redmanduck/wins/README.md

# Wi-Fi Indoor Navigation System 

GPS is the standard for navigation in embedded electronics today, but GPS signals are largely incapable of penetrating structures and providing an accurate or functional navigation system for indoor use. The Indoor Navigation System project is an attempt to address this issue, by combining multiple sensor techniques together to provide an accurate means of navigating an object indoors.

[Map]

Package (https://dl.dropboxusercontent.com/u/41564792/pi.png)
