redmanduck/wins/pic/last_working.X/Makefile.htm

Skip to content

(https://github.com/)

This repository

- Explore
- Gist (https://gist.github.com)
- Blog
- Help (https://help.github.com)
- @dkenzheb dkenzheb
  - New repository
  - New organization
  - This repository
  - New issue
- Unwatch 4
  Notifications
  Not watching Be notified when participating or @mentioned. Watch
  Watching Be notified of all conversations. Unwatch
  Ignoring Never be notified. Stop ignoring
- Unstar 1
  Star 1
- Fork 0

# ssabpisa/wins private 

### HTTPS clone URL

### SSH clone URL

### Subversion checkout URL

You can clone with HTTPS, SSH, or Subversion. (https://help.github.com/articles/which-remote-url-should-i-use)

Clone in Desktop (https://windows.github.com) Download ZIP

Permalink

branch: master

Switch branches/tags

- Branches
- Tags

master

Create branch: from ‘master’

Nothing to show

wins/pic/project.X/Makefile

Fetching contributors…



Cannot retrieve contributors at this time

Raw Blame History

(https://windows.github.com)

114 lines (87 sloc) 3.381 kb

| # There exist several targets which are by default empty and which can be
| # used for execution of your targets. These targets are usually executed
| # before and after some main targets. They are:
| # .build-pre: called before 'build' target
| # .build-post: called after 'build' target
| # .clean-pre: called before 'clean' target
| # .clean-post: called after 'clean' target
| # .clobber-pre: called before 'clobber' target
| # .clobber-post: called after 'clobber' target
| # .all-pre: called before 'all' target
| # .all-post: called after 'all' target
| # .help-pre: called before 'help' target
| # .help-post: called after 'help' target
| # Targets beginning with '.' are not intended to be called on their own.
| # Main targets can be executed directly, and they are:
| # build build a specific configuration
| # clean remove built files from a configuration
| # clobber remove all built files
| # all build all configurations
| # help print help mesage
| # Targets .build-impl, .clean-impl, .clobber-impl, .all-impl, and
| # .help-impl are implemented in nbproject/makefile-impl.mk.
| # Available make variables:
| # CND_BASEDIR base directory for relative paths
| # CND_DISTDIR default top distribution directory (build artifacts)
| # CND_BUILDDIR default top build directory (object files, ...)
| # CONF name of current configuration
| # CND_ARTIFACT_DIR_${CONF} directory of build artifact (current configuration)
| # CND_ARTIFACT_NAME_${CONF} name of build artifact (current configuration)
| # CND_ARTIFACT_PATH_${CONF} path to build artifact (current configuration)
| # CND_PACKAGE_DIR_${CONF} directory of package (current configuration)
| # CND_PACKAGE_NAME_${CONF} name of package (current configuration)
| # CND_PACKAGE_PATH_${CONF} path to package (current configuration)
| # NOCDDL
| # Environment
| MKDIR=mkdir
| CP=cp
| CCADMIN=CCadmin
| RANLIB=ranlib
| # build
| build: .build-post
| .build-pre:
| # Add your pre 'build' code here...
| .build-post: .build-impl
| # Add your post 'build' code here...
| # clean
| clean: .clean-post
| .clean-pre:
| # Add your pre 'clean' code here...
| # WARNING: the IDE does not call this target since it takes a long time to
| # simply run make. Instead, the IDE removes the configuration directories
| # under build and dist directly without calling make.
| # This target is left here so people can do a clean when running a clean
| # outside the IDE.
| .clean-post: .clean-impl
| # Add your post 'clean' code here...
| # clobber
| clobber: .clobber-post
| .clobber-pre:
| # Add your pre 'clobber' code here...
| .clobber-post: .clobber-impl
| # Add your post 'clobber' code here...
| # all
| all: .all-post
| .all-pre:
| # Add your pre 'all' code here...
| .all-post: .all-impl
| # Add your post 'all' code here...
| # help
| help: .help-post
| .help-pre:
| # Add your pre 'help' code here...
| .help-post: .help-impl
| # Add your post 'help' code here...
| # include project implementation makefile
| include nbproject/Makefile-impl.mk
| # include project make variables
| include nbproject/Makefile-variables.mk

Go

- Status (https://status.github.com/)
- API (https://developer.github.com)
- Training (https://training.github.com)
- Shop (https://shop.github.com)
- Blog (https://github.com/blog)
- About (https://github.com/about)

(https://github.com)

- © 2015 GitHub, Inc.
- Terms (https://github.com/site/terms)
- Privacy (https://github.com/site/privacy)
- Security (https://github.com/security)
- Contact (https://github.com/contact)

Something went wrong with that request. Please try again.
