redmanduck/wins/raspi/localization/results/plots/0_f0_25_72_70_9e_7f.png

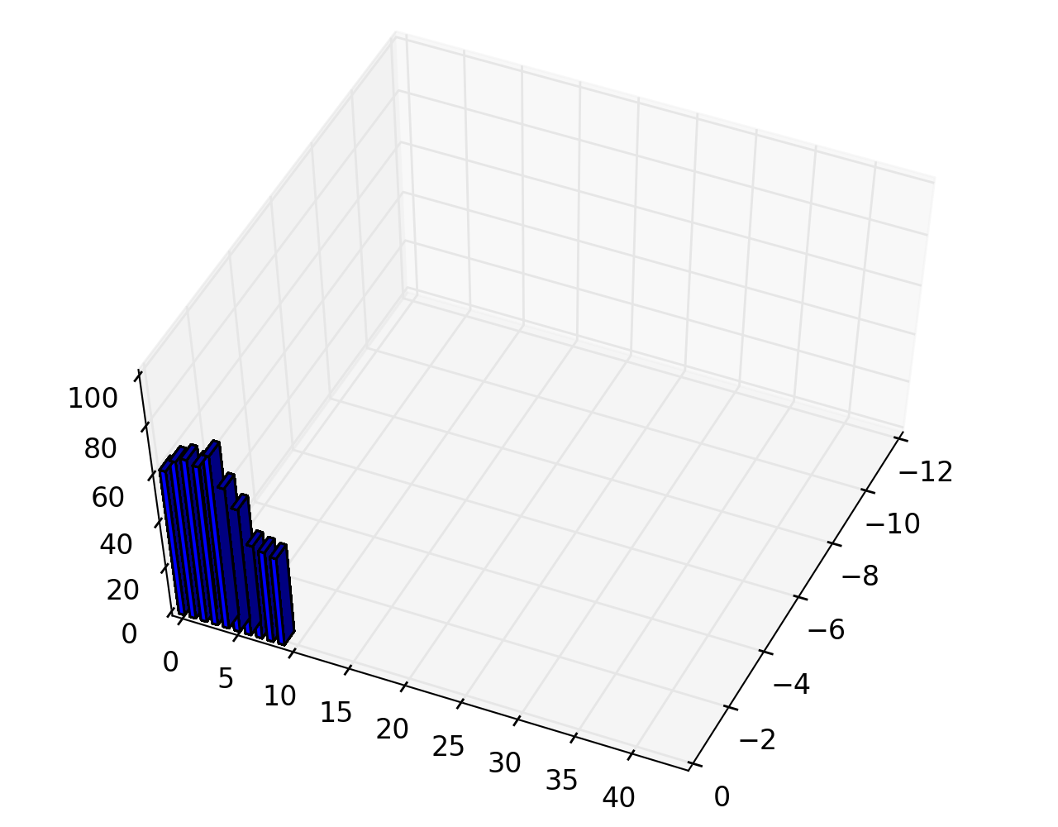
raspi/localization/results/plots/0_f0_25_72_70_9e_7f.png
