redmanduck/wins/raspi/localization/results/plots/1_f0_25_72_7d_8b_3d.png

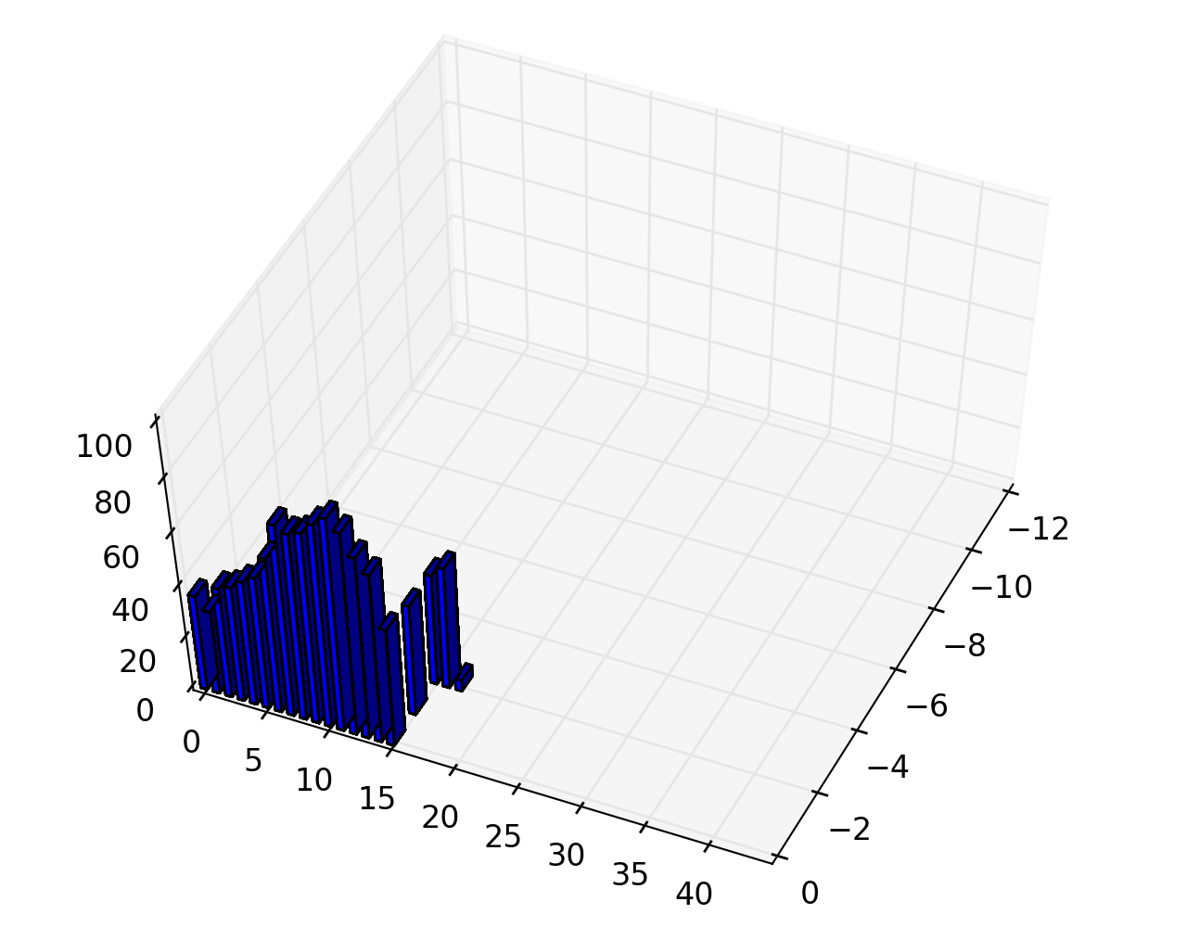
raspi/localization/results/plots/1_f0_25_72_7d_8b_3d.png
