redmanduck/wins/raspi/localization/results/plots/70_00_22_75_43_1f_68.png

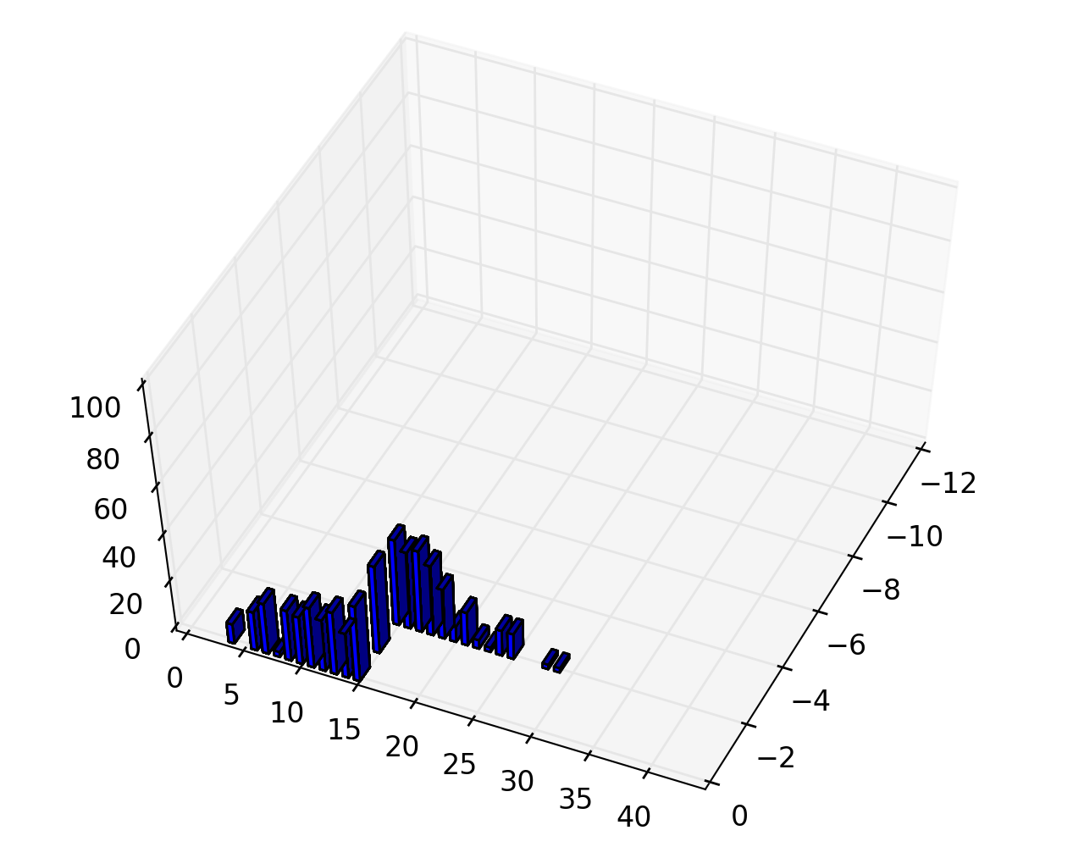
raspi/localization/results/plots/70_00_22_75_43_1f_68.png
