redmanduck/wins/raspi/localization/results/plots/105_f0_25_72_7d_88_79.png

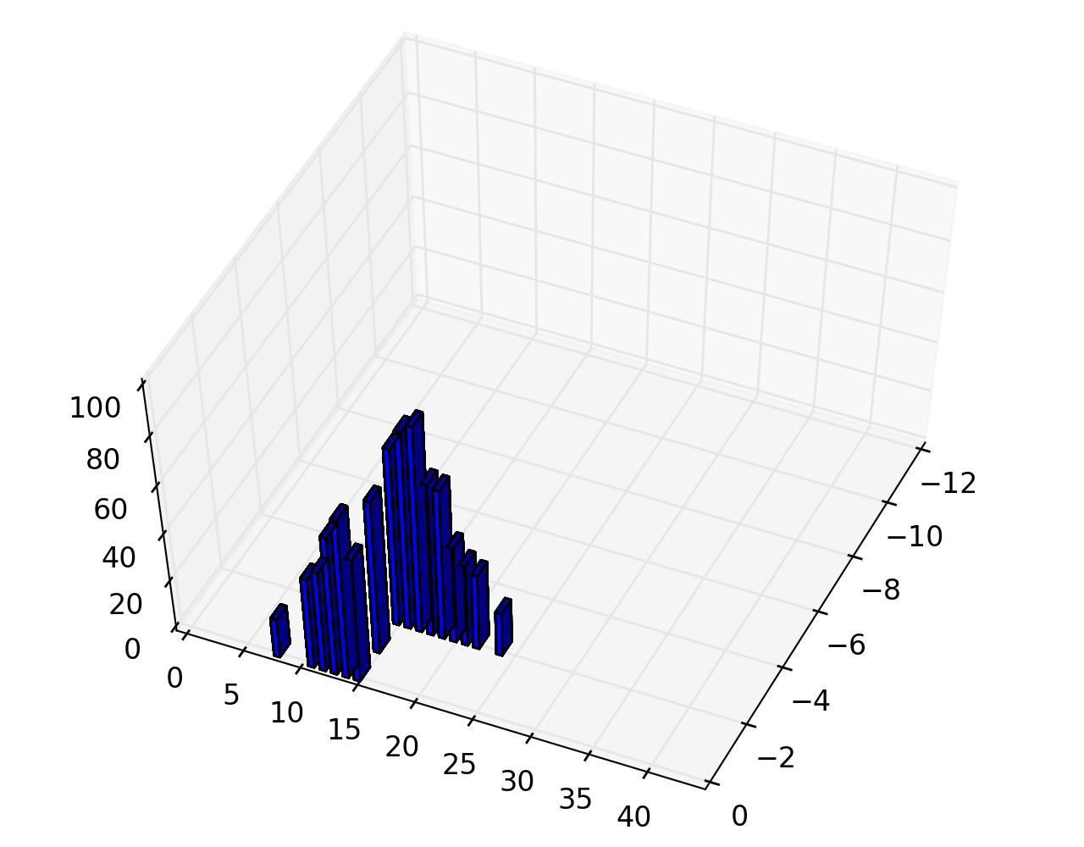
raspi/localization/results/plots/105_f0_25_72_7d_88_79.png
