redmanduck/wins/raspi/localization/results/plots/123_f0_25_72_7d_8a_cf.png

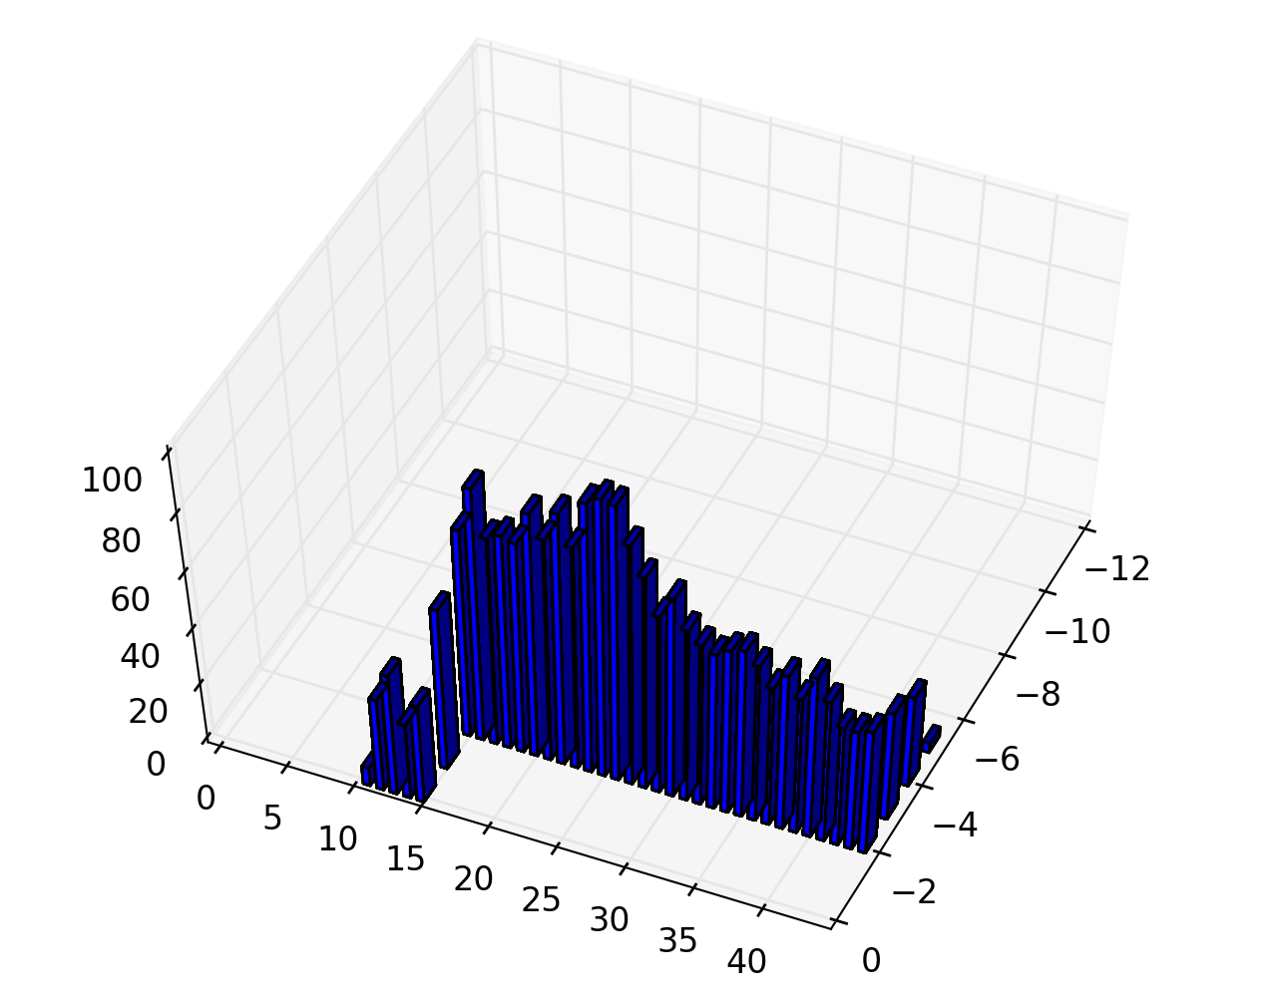
raspi/localization/results/plots/123_f0_25_72_7d_8a_cf.png
