redmanduck/wins/raspi/localization/results/plots/133_f0_25_72_7d_4f_3d.png

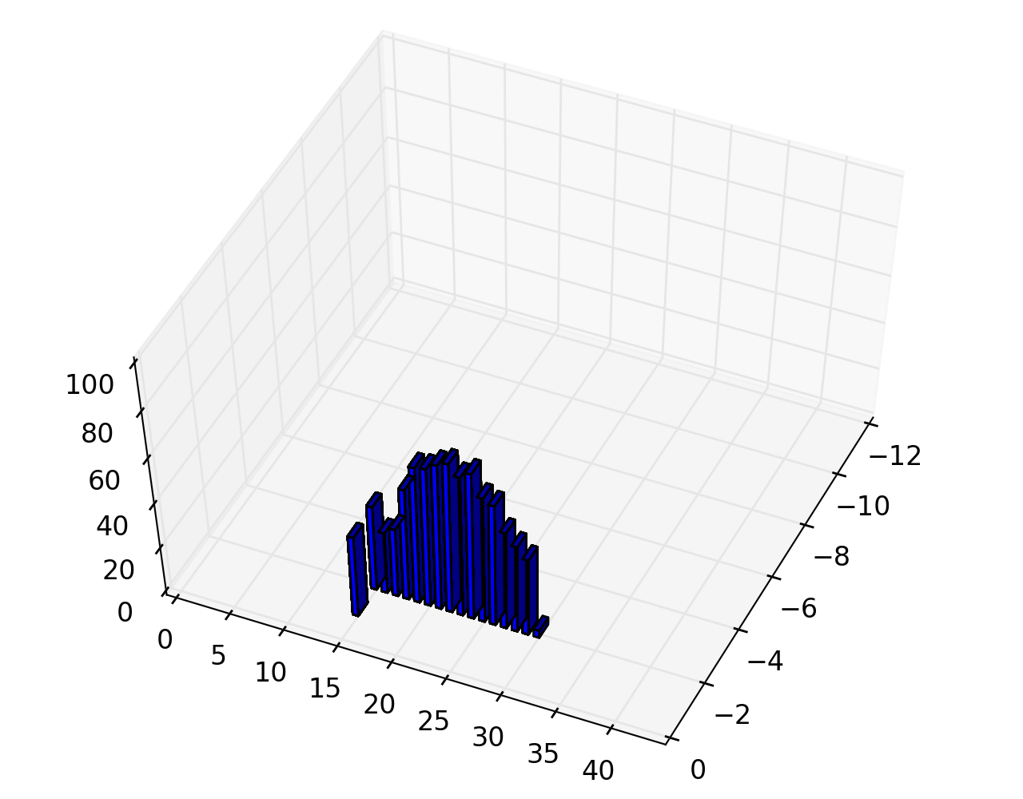
raspi/localization/results/plots/133_f0_25_72_7d_4f_3d.png
