redmanduck/wins/raspi/localization/results/plots/137_f0_25_72_7d_8a_c4.png

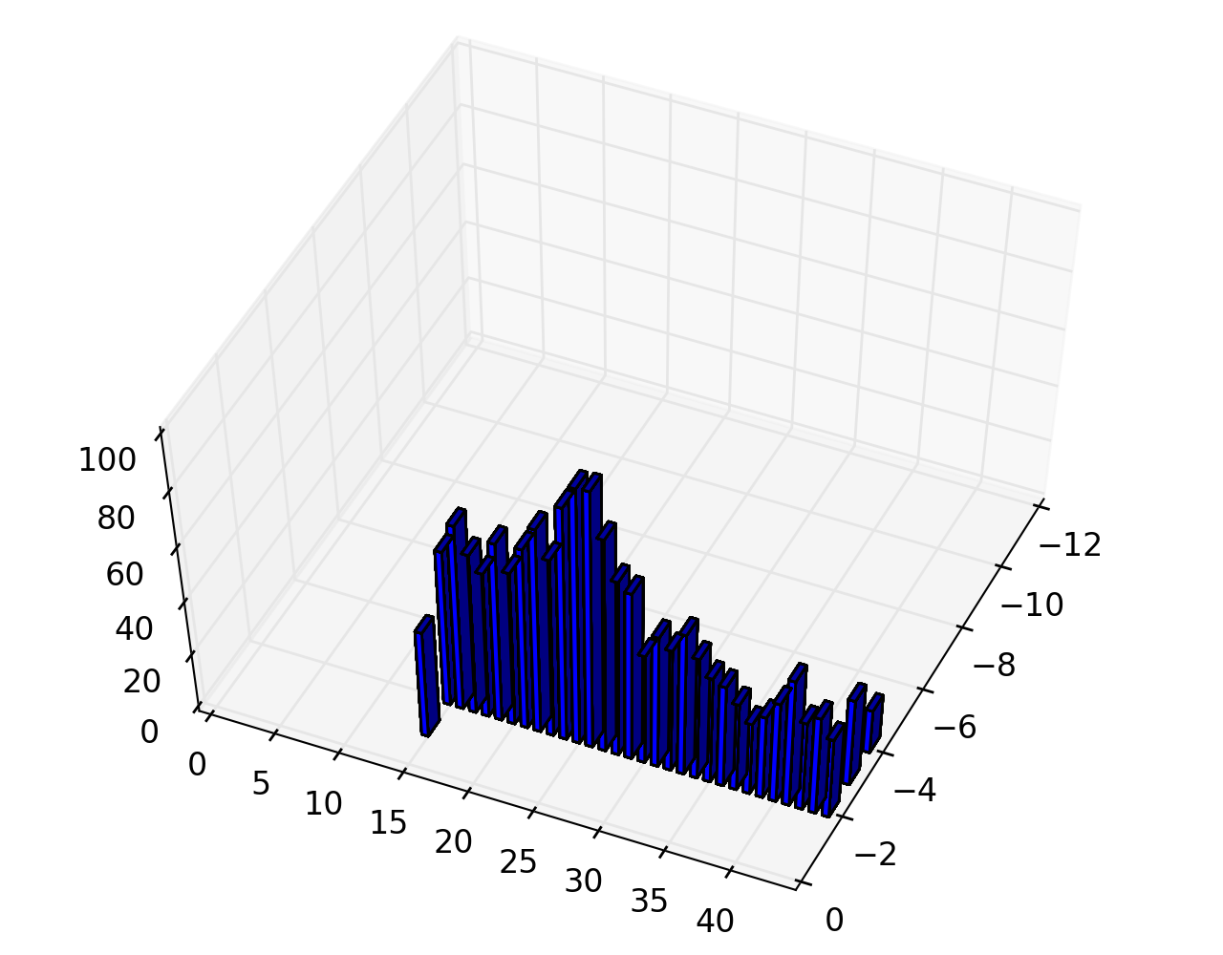
raspi/localization/results/plots/137_f0_25_72_7d_8a_c4.png
