redmanduck/wins/raspi/localization/results/plots/143_f0_25_72_7d_fc_59.png

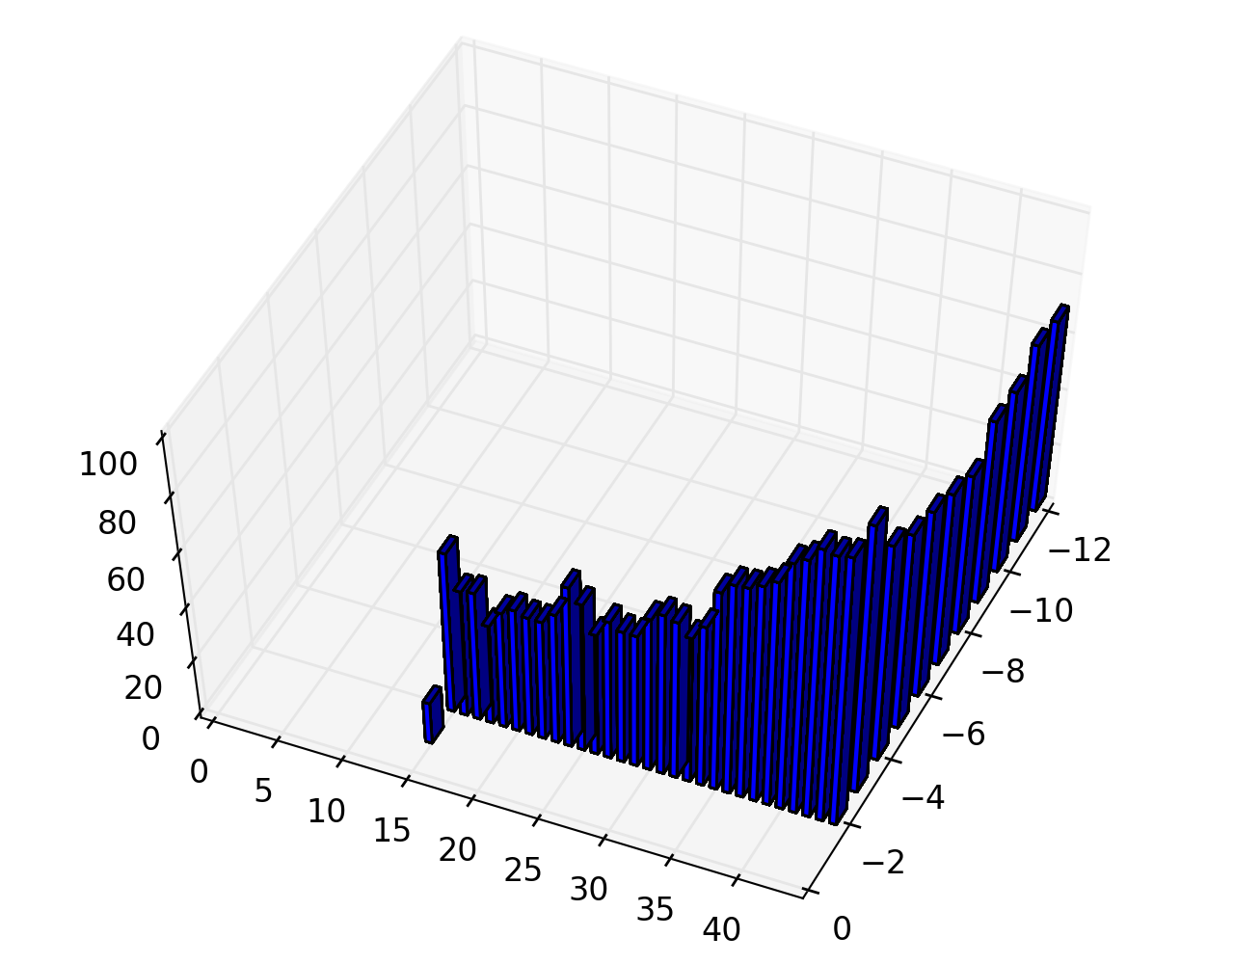
raspi/localization/results/plots/143_f0_25_72_7d_fc_59.png
