redmanduck/wins/raspi/localization/results/plots/165_f0_25_72_7d_7c_a4.png

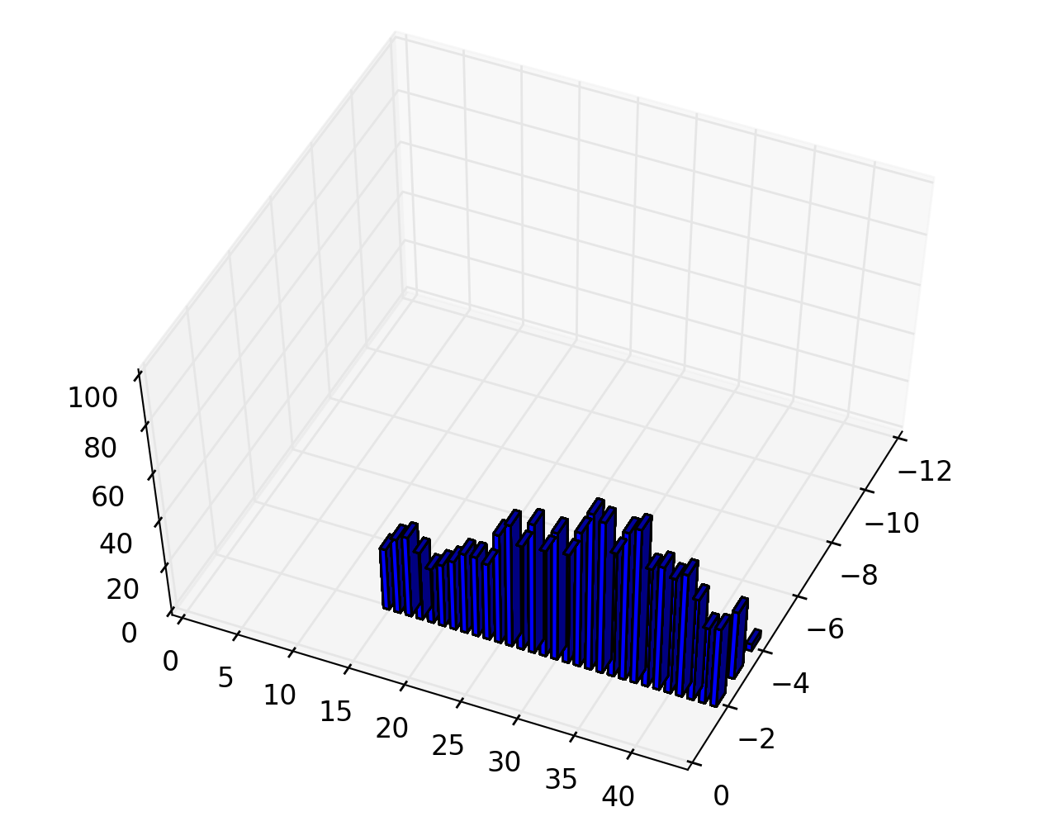
raspi/localization/results/plots/165_f0_25_72_7d_7c_a4.png
