redmanduck/wins/raspi/localization/results/plots/167_f0_25_72_7d_fc_50.png

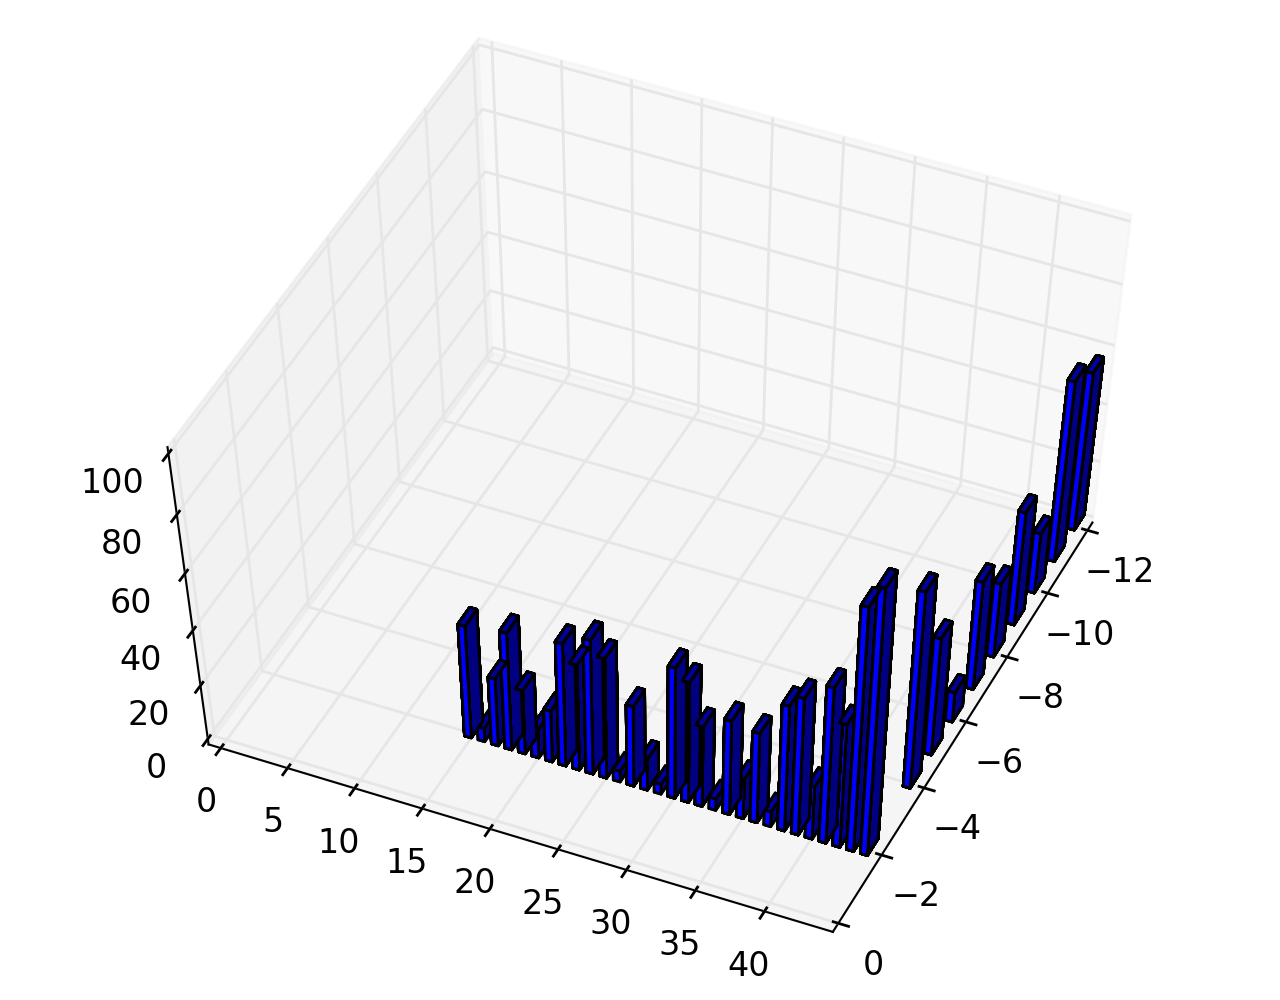
raspi/localization/results/plots/167_f0_25_72_7d_fc_50.png
