redmanduck/wins/raspi/localization/results/plots/169_f0_25_72_7d_88_f0.png

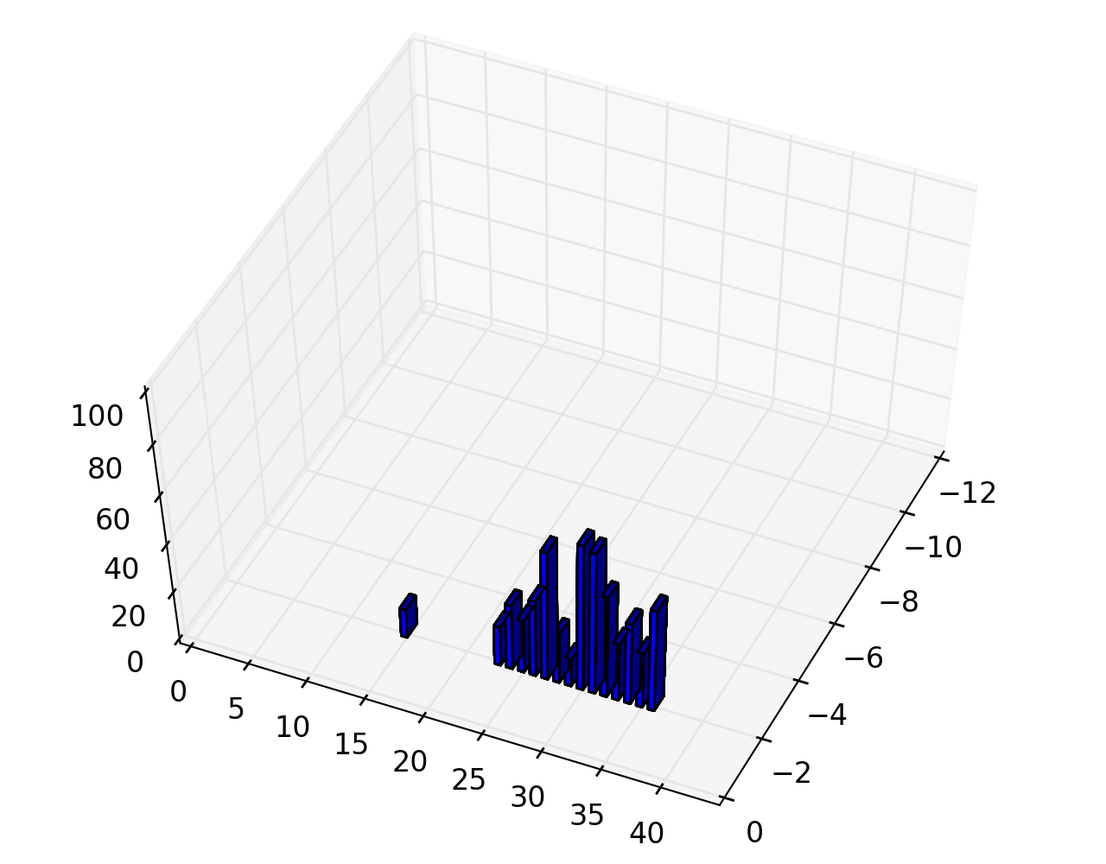
raspi/localization/results/plots/169_f0_25_72_7d_88_f0.png
