redmanduck/wins/raspi/localization/results/plots/187_f0_25_72_7d_ab_cf.png

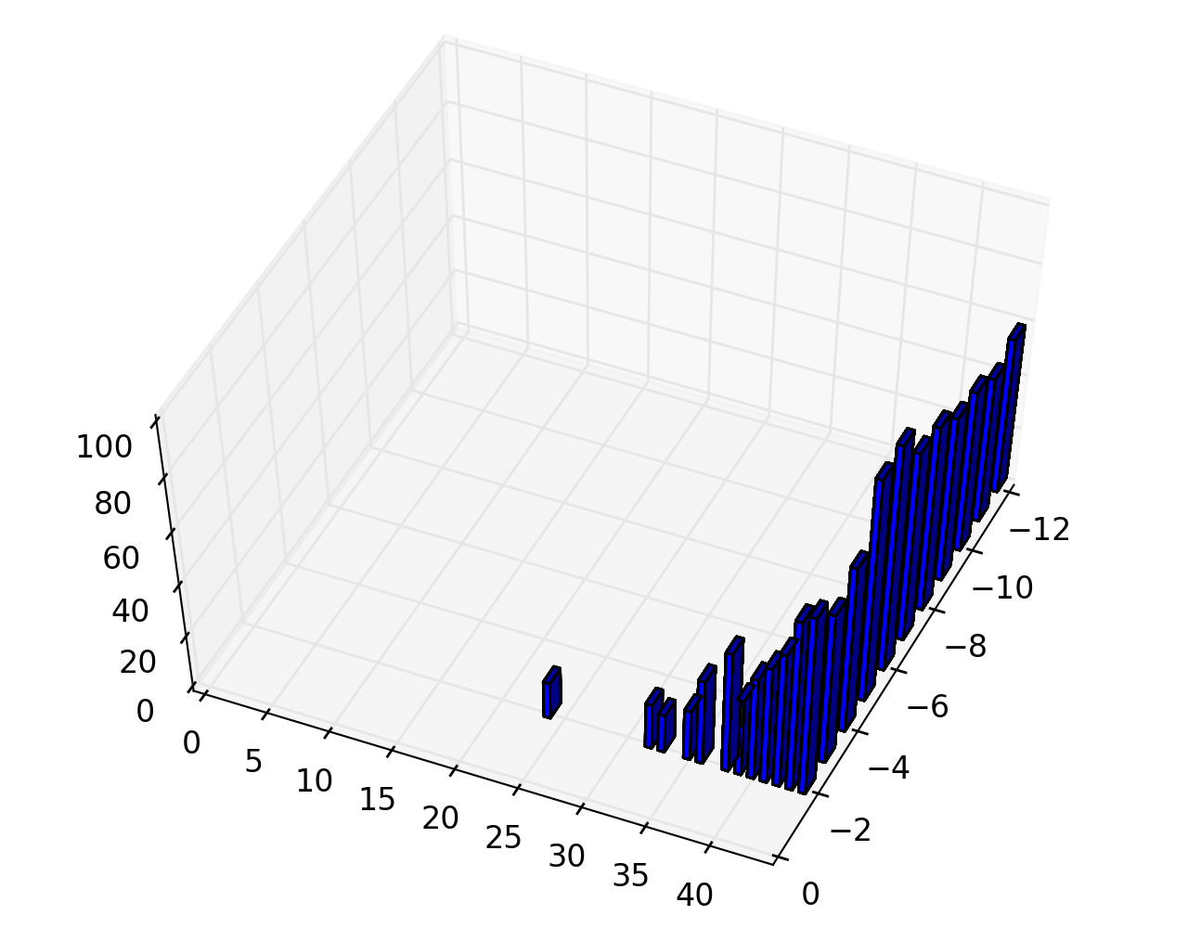
raspi/localization/results/plots/187_f0_25_72_7d_ab_cf.png
