redmanduck/wins/raspi/localization/results/plots/224_f0_25_72_7d_7e_b2.png

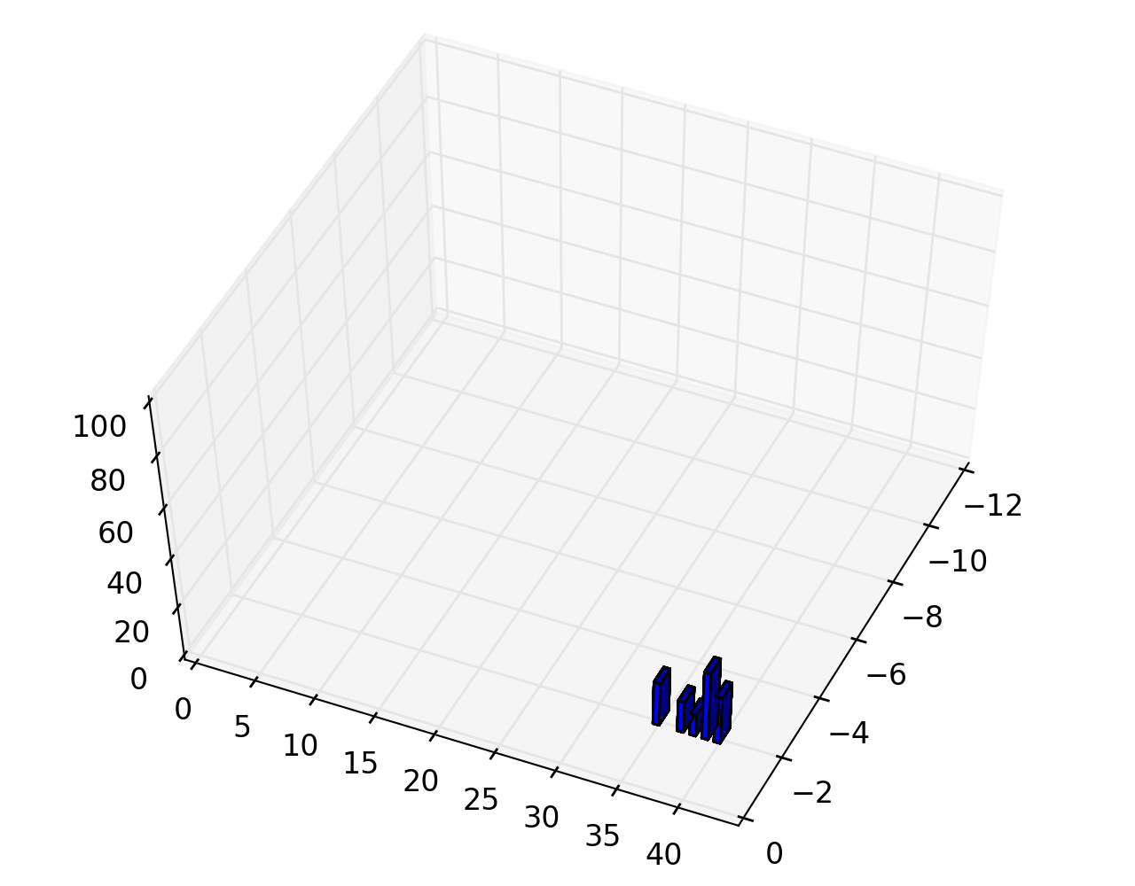
raspi/localization/results/plots/224_f0_25_72_7d_7e_b2.png
