redmanduck/wins/testing/docs/First Run A0.png

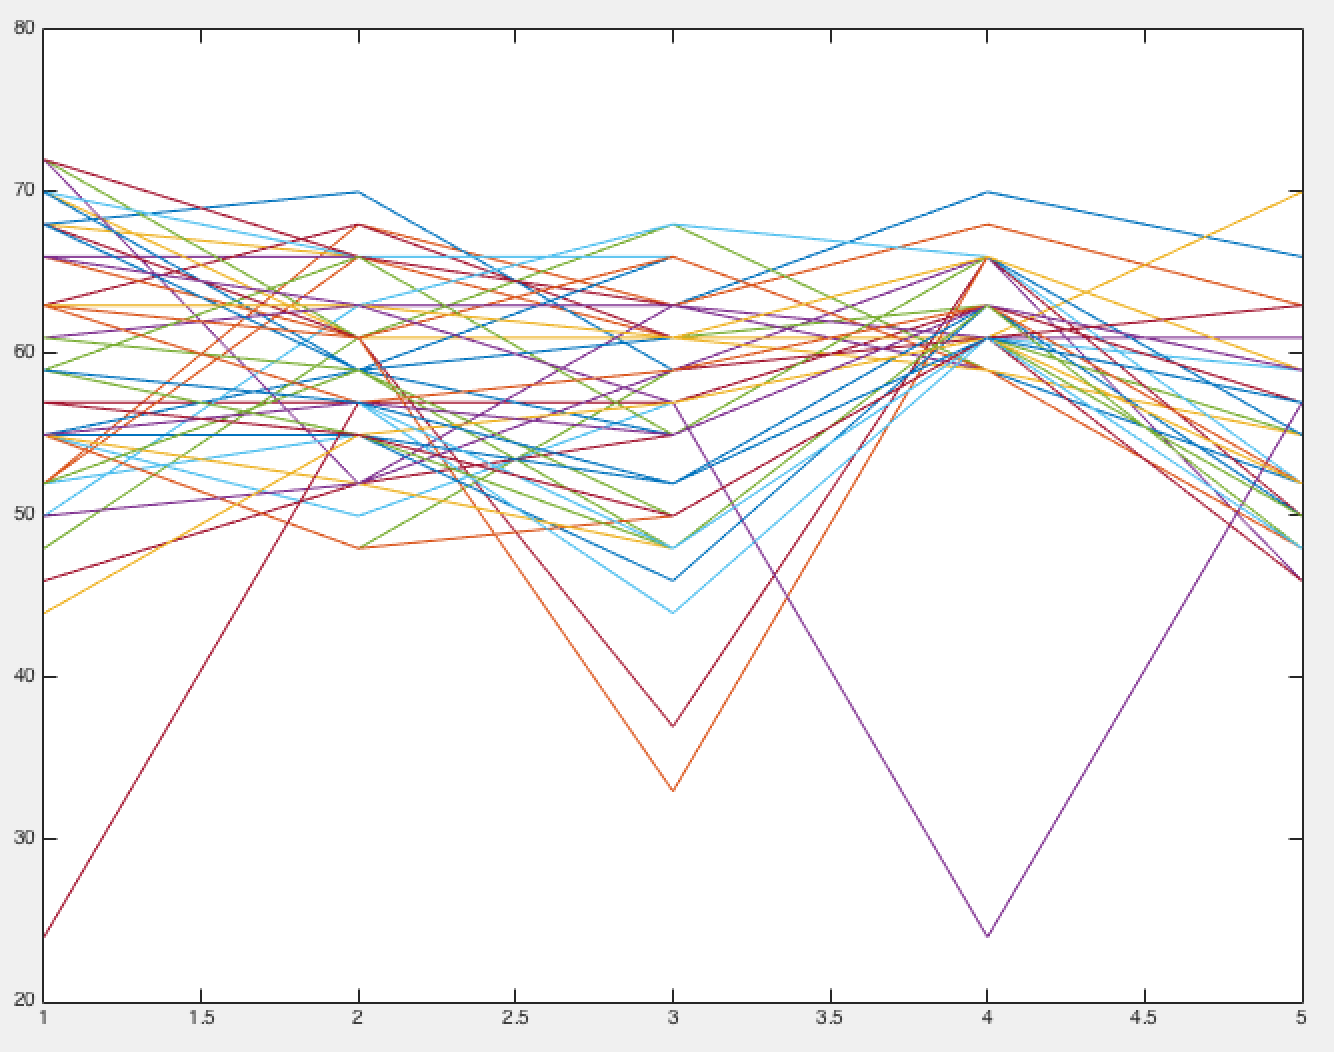
testing/docs/First Run A0.png
