redmanduck/wins/testing/docs/First Run A1.png

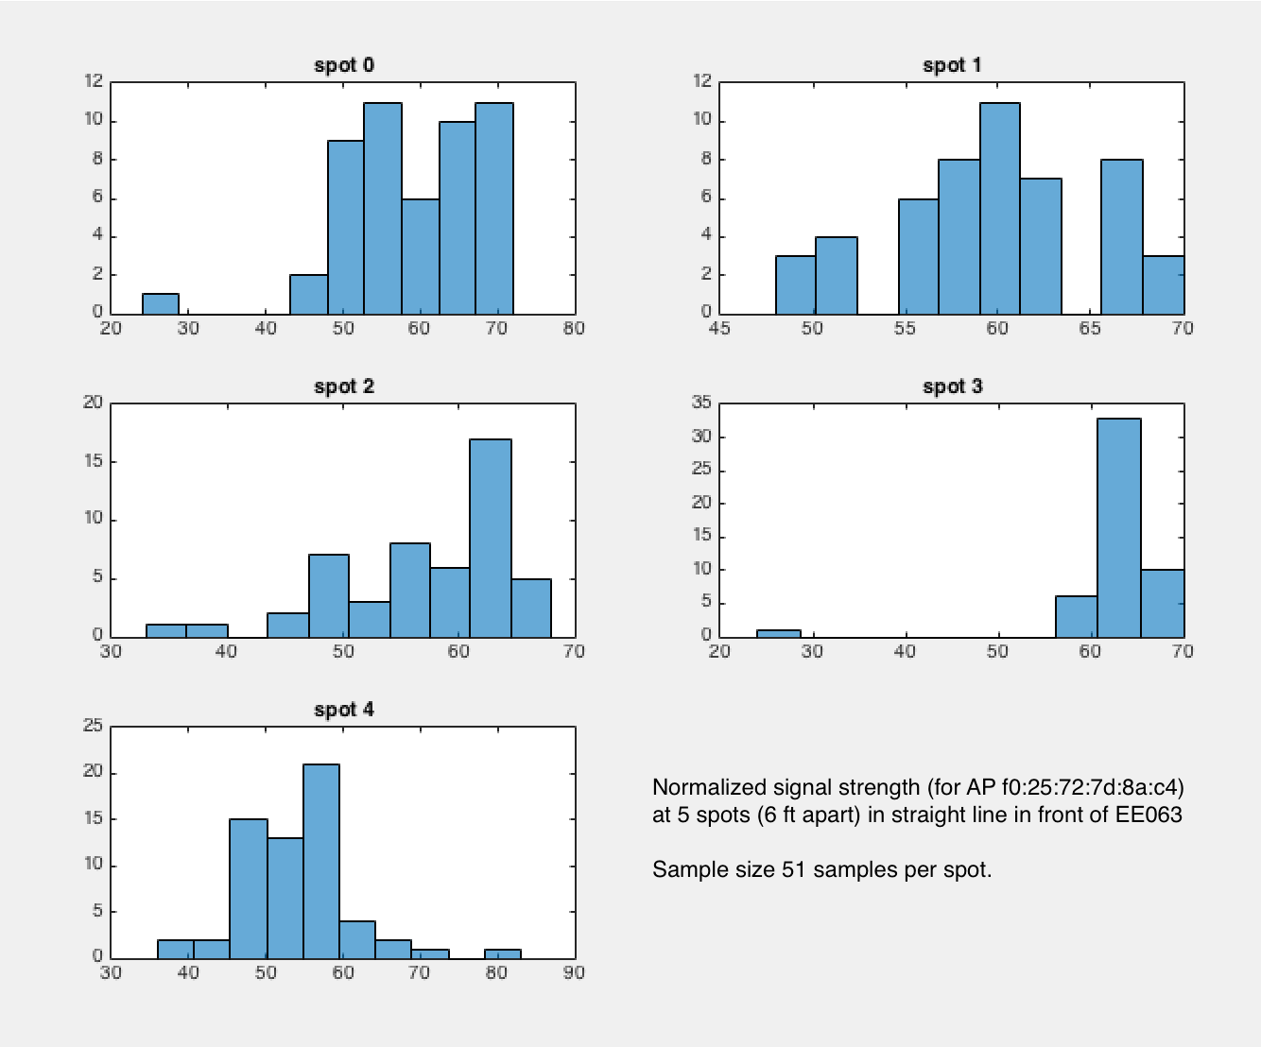
testing/docs/First Run A1.png
