redmanduck/wins/testing/docs/First Run A2.png

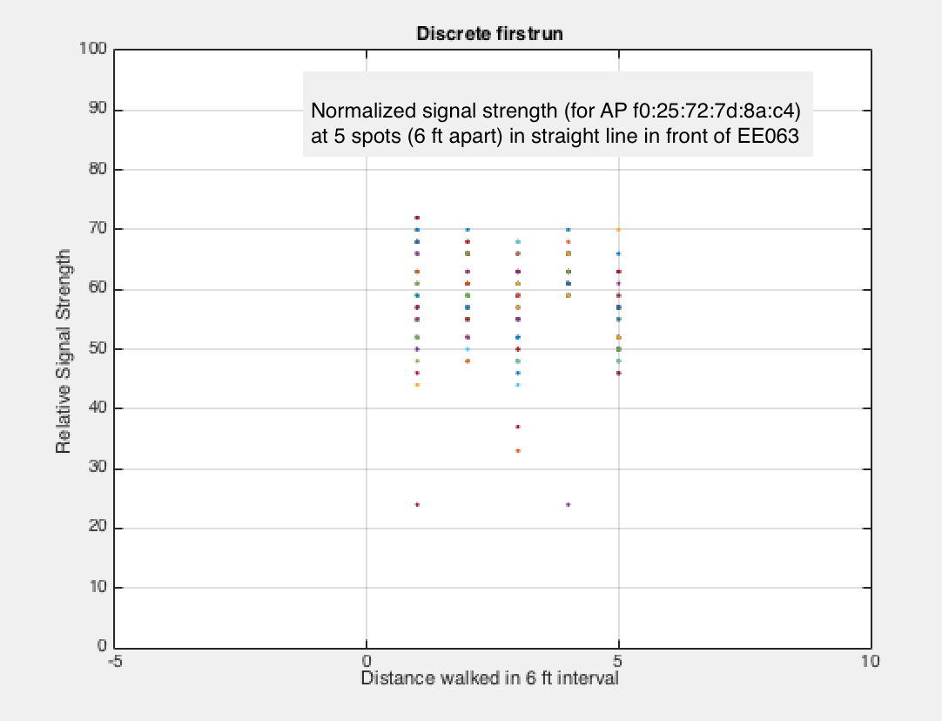
testing/docs/First Run A2.png
