redmanduck/wins/pcb/pcb_REV2/rev2.pdf

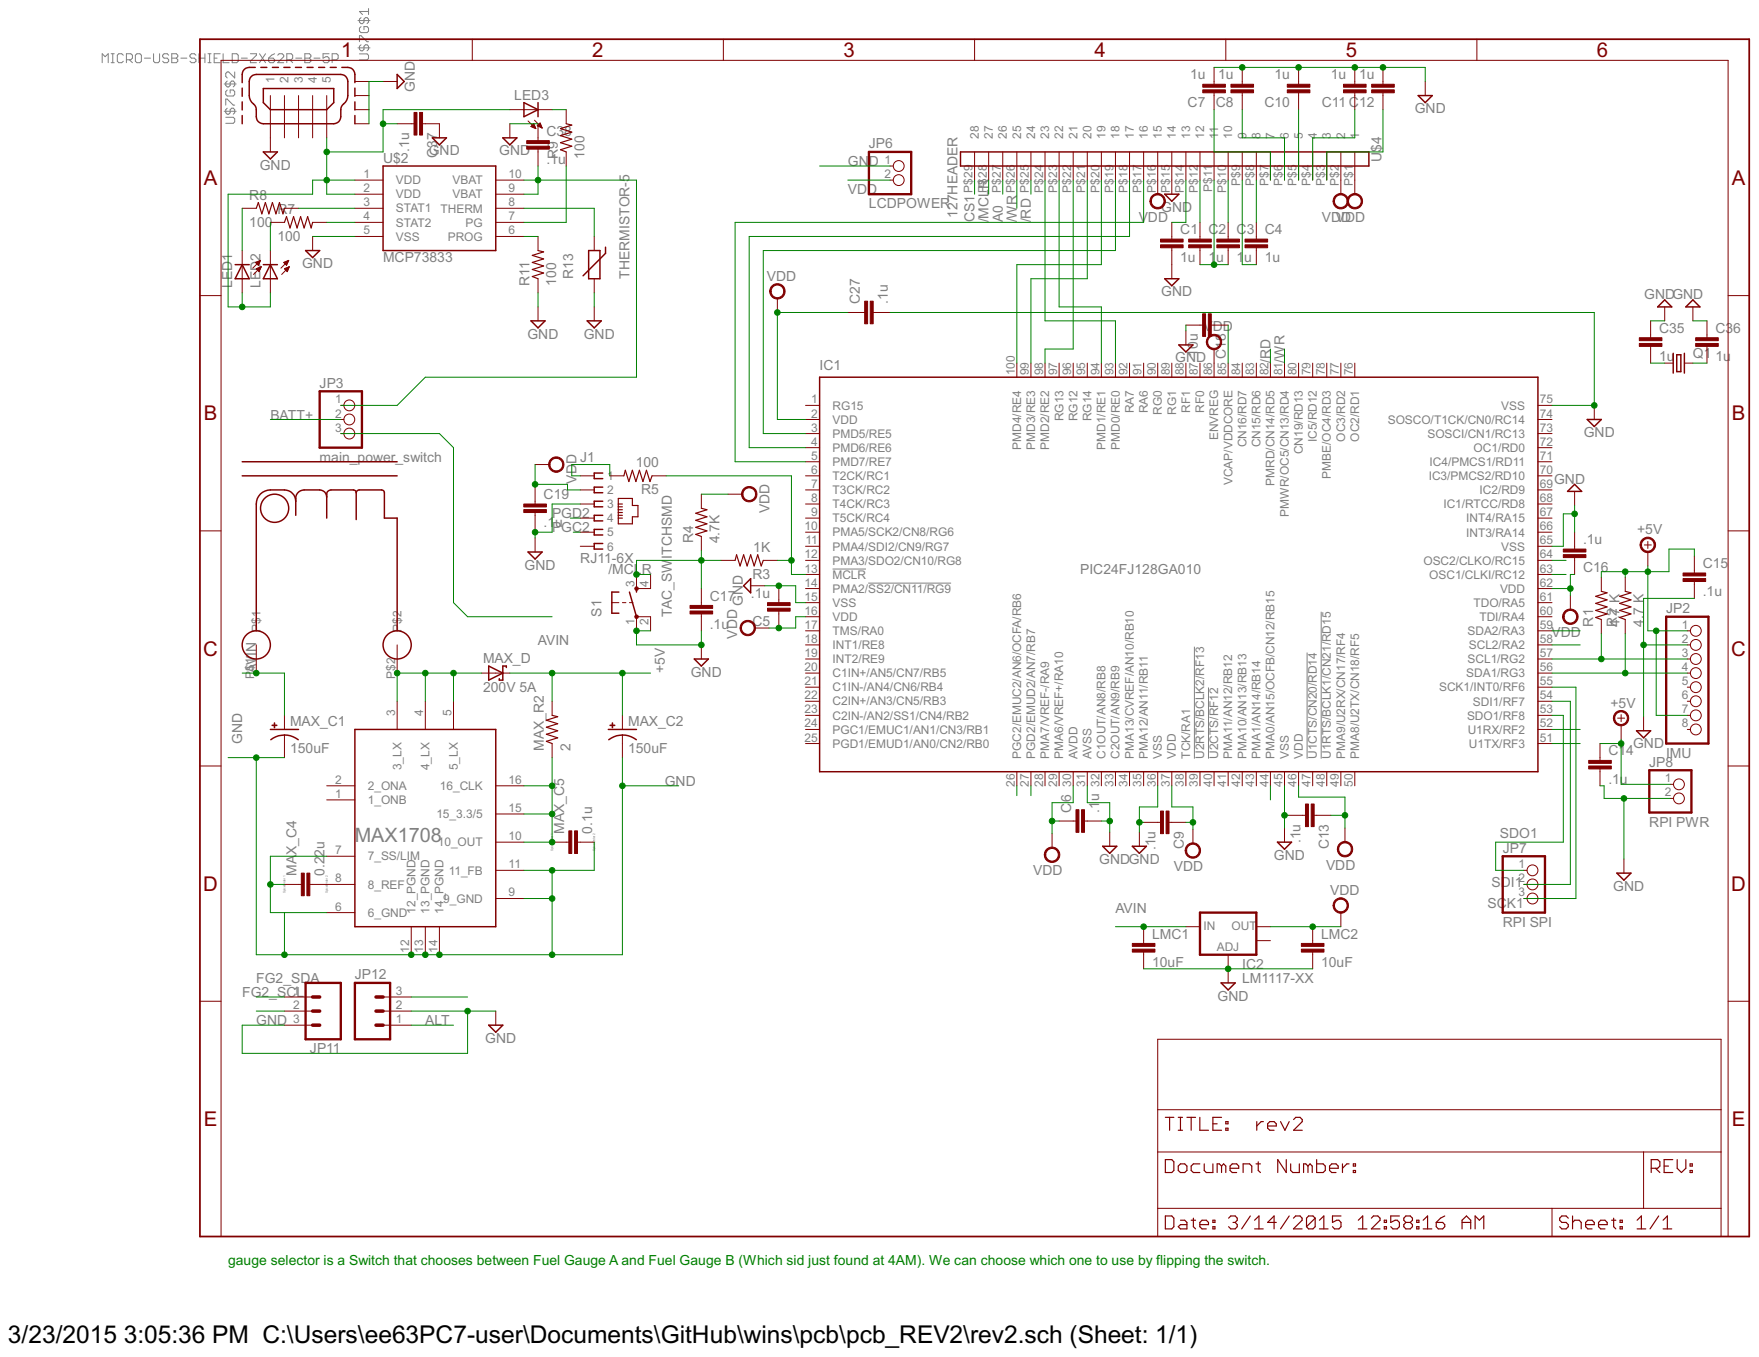
[picture p32: page 1]

5 6 7

gauge selector is a Switch that chooses between Fuel Gauge A and Fuel Gauge B (Which sid just found at 4AM). We can choose which one to use by flipping the switch.

3/23/2015 3:05:36 PM C:\Users\ee63PC7-user\Documents\GitHub\wins\pcb\pcb_REV2\rev2.sch (Sheet: 1/1)
