redmanduck/wins/pcb/pcb_REV2/rev2.brd

## EAGLE design pcb/pcb_REV2/rev2.brd (2015-04-08)

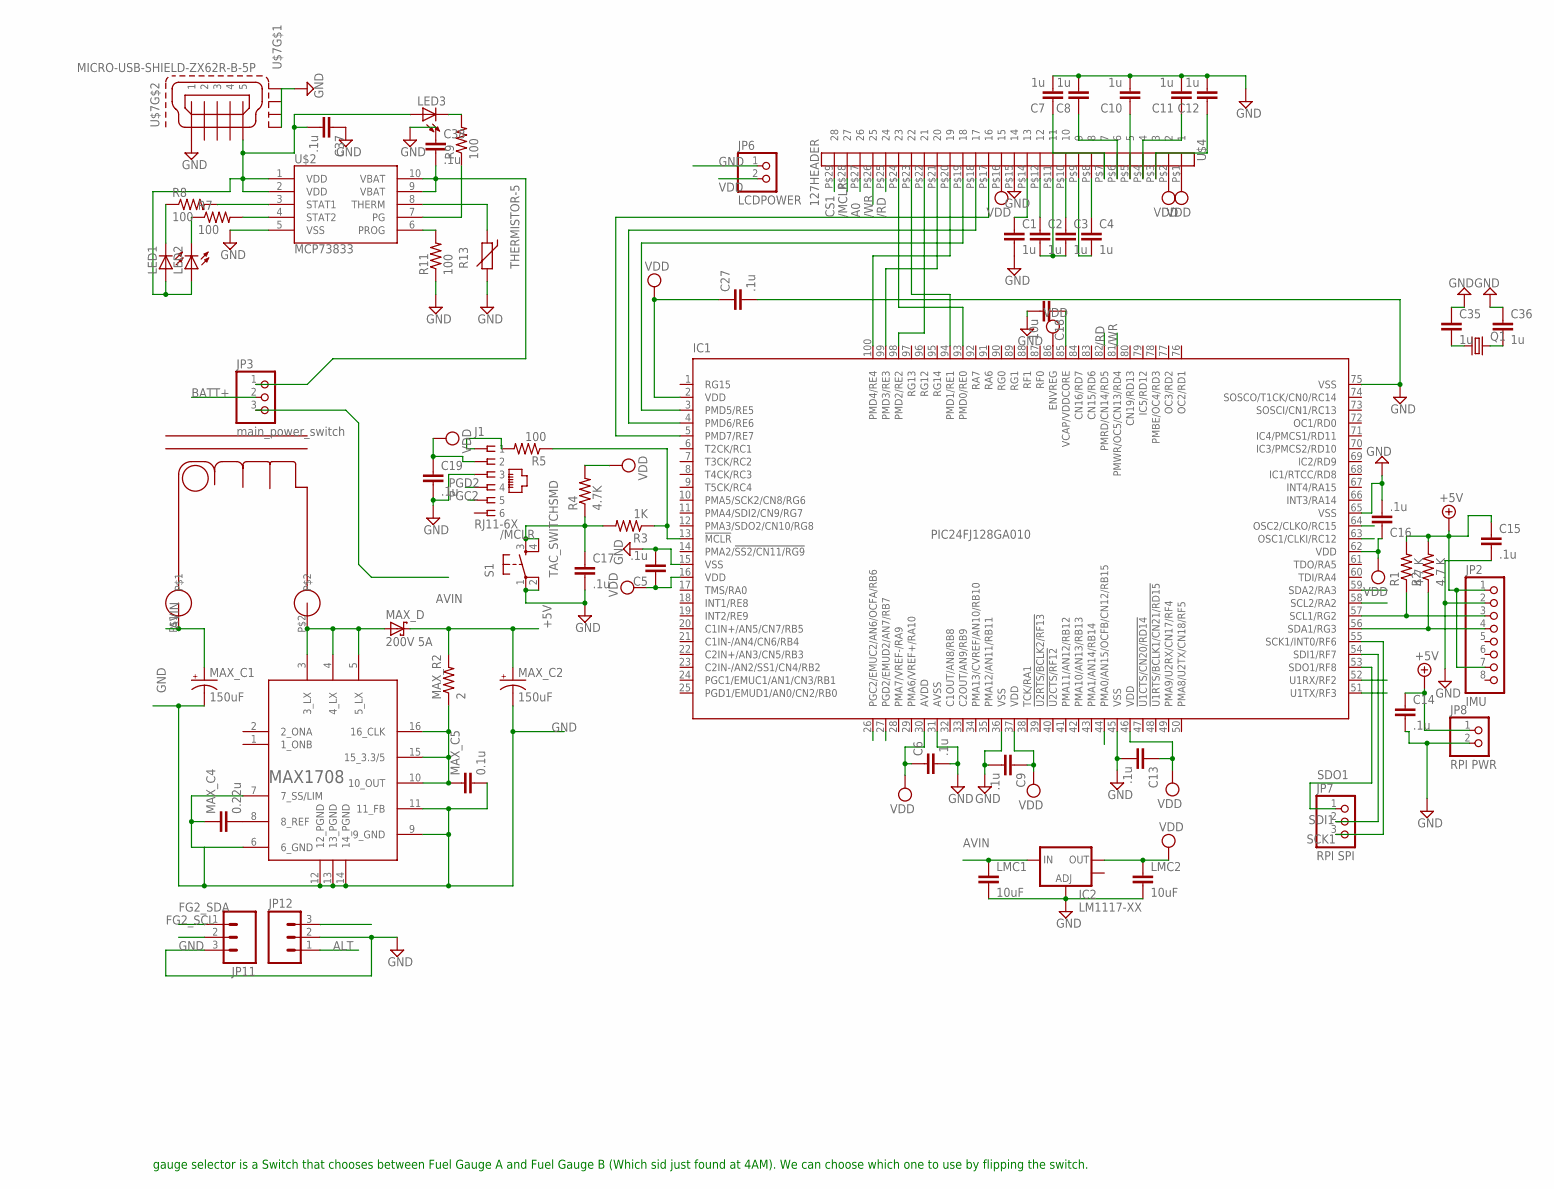
[picture p33: schematic rev2.sch, Version A]

Parts:
C1, C2, C3, C4, C7, C8, C10, C11, C12, C35, C36: 1u; C1206
C5, C6, C9, C13, C14, C15, C16, C17, C19, C27, C37, C38: .1u; C1206
C18: 10u; C1206
IC1: PIC24FJ128GA010; TQFP100-14X14
IC2: LM1117-XX; SOT223
J1: RJ11-6X; RJ11-NO_SHIELD
JP2: IMU; 1X08
JP3: main_power_switch; 1X03
JP6: LCDPOWER; 1X02
JP7: RPI SPI; 1X03
JP8: RPI PWR; 1X02
JP11, JP12: M03PTH; 1X03
LED1, LED2, LED3: LEDSMT1206; 1206
LMC1, LMC2: 10uF; C1206
MAX_C1, MAX_C2: 150uF; CT7343
MAX_C4: 0.22u; C1206
MAX_C5: 0.1u; C1206
MAX_D: 200V 5A; SMC
MAX_R2: 2; R1206
Q1: CRYTALHC49U-V; HC49U-V
R1, R2: 4.7 K; R1206
R3: 1K; R1206
R4: 4.7K; R1206
R5, R7, R8, R9, R11: 100; R1206
R13: THERMISTOR-5; R-5
S1: TAC_SWITCHSMD; TACTILE-SWITCH-SMD
U$2: MCP73833; MSOP10
U$3: MAX1708; QSOP16
U$4: 127HEADER; 1.27HEADER
U$6: UP2B-2R2-R
U$7: MICRO-USB-SHIELD-ZX62R-B-5P; ZX62R-B-5P

Connections:
+5V: C14.1, C15.1, JP2.1, JP2.7, JP8.1, MAX_C2.+, MAX_D.C, MAX_R2.2, R1.2, R2.2
/MCLR: C17.1, R3.2, R4.1, S1.3, S1.4, U$4.P$28 (27)
/RD: IC1.82 (PMRD/CN14/RD5), U$4.P$25 (24)
/WR: IC1.81 (PMWR/OC5/CN13/RD4), U$4.P$26 (25)
A0: IC1.44 (PMA0/AN15/OCFB/CN12/RB15), U$4.P$27 (26)
ALT: JP12.1
AVIN: IC2.3 (IN), JP3.3, LMC1.1, MAX_C1.+, U$6.P$1
BATT+: JP3.2, JP12.3
CS1: U$4.P$29 (28)
DS_DATA: IC1.52 (U1RX/RF2)
FG2_SCL: IC1.58 (SCL2/RA2), JP11.2
FG2_SDA: IC1.59 (SDA2/RA3), JP11.1
GND: C1.2, C5.2, C6.2, C7.2, C8.2, C9.2, C10.2, C11.2, C12.2, C13.2, C14.2, C15.2, C16.2, C17.2, C18.2, C19.2, C27.2, C35.1, C36.1, C37.1, C38.1, IC1.15 (VSS), IC1.31 (AVSS), IC1.36 (VSS), IC1.45 (VSS), IC1.65 (VSS), IC1.75 (VSS), IC2.1 (ADJ), J1.3, JP2.2, JP6.1, JP8.2, JP11.3, JP12.2, LMC1.2, LMC2.2, MAX_C1.-, MAX_C2.-, MAX_C4.1, MAX_C5.2, R11.1, R13.2, S1.1, S1.2, U$2.5 (VSS), U$3.6 (6_GND), U$3.7 (7_SS/LIM), U$3.9 (9_GND), U$3.11 (11_FB), U$3.12 (12_PGND), U$3.13 (13_PGND), U$3.14 (14_PGND), U$4.P$15 (14), U$7.1, U$7.M1 (S1), U$7.M2 (S2), U$7.M3 (S3), U$7.M4 (S4)
unnamed: IC1.57 (SCL1/RG2), JP2.3, R1.1
unnamed: IC1.56 (SDA1/RG3), JP2.4, R2.1
unnamed: LED1.C, R8.1
unnamed: IC1.13 (!MCLR), R3.1, R5.1
unnamed: R8.2, U$2.3 (STAT1)
unnamed: R7.2, U$2.4 (STAT2)
unnamed: C18.1, IC1.85 (VCAP/VDDCORE)
unnamed: IC1.5 (PMD7/RE7), U$4.P$17 (16)
unnamed: IC1.4 (PMD6/RE6), U$4.P$18 (17)
unnamed: IC1.3 (PMD5/RE5), U$4.P$19 (18)
unnamed: IC1.100 (PMD4/RE4), U$4.P$20 (19)
unnamed: IC1.99 (PMD3/RE3), U$4.P$21 (20)
unnamed: IC1.98 (PMD2/RE2), U$4.P$22 (21)
unnamed: IC1.94 (PMD1/RE1), U$4.P$23 (22)
unnamed: IC1.93 (PMD0/RE0), U$4.P$24 (23)
unnamed: C7.1, U$4.P$7 (7)
unnamed: C3.1, U$4.P$10 (10)
unnamed: LED2.C, R7.1
unnamed: C2.1, U$4.P$12 (12)
unnamed: C2.2, C3.2, U$4.P$11 (11)
unnamed: C1.1, U$4.P$14 (13)
unnamed: C4.2, U$4.P$9 (9)
unnamed: C4.1, U$4.P$8 (8)
unnamed: C8.1, U$4.P$6 (6)
unnamed: C10.1, U$4.P$5 (5)
unnamed: C11.1, U$4.P$4 (4)
unnamed: C12.1, U$4.P$3 (3)
unnamed: R9.1, U$2.7 (PG)
unnamed: J1.1, R5.2
unnamed: LED3.C, R9.2
unnamed: R11.2, U$2.6 (PROG)
unnamed: R13.1, U$2.8 (THERM)
unnamed: MAX_D.A, U$3.3 (3_LX), U$3.4 (4_LX), U$3.5 (5_LX), U$6.P$2
unnamed: MAX_C5.1, MAX_R2.1, U$3.10 (10_OUT), U$3.15 (15_3.3/5), U$3.16 (16_CLK)
unnamed: MAX_C4.2, U$3.8 (8_REF)
unnamed: C38.2, JP3.1, U$2.9 (VBAT), U$2.10 (VBAT)
OSC1: C36.2, IC1.63 (OSC1/CLKI/RC12), Q1.2
OSC2: C35.2, IC1.64 (OSC2/CLKO/RC15), Q1.1
PGC2: IC1.26 (PGC2/EMUC2/AN6/OCFA/RB6), J1.5
PGD2: IC1.27 (PGD2/EMUD2/AN7/RB7), J1.4
PIO: IC1.51 (U1TX/RF3)
SCK1: IC1.55 (SCK1/INT0/RF6), JP7.3
SDI1: IC1.54 (SDI1/RF7), JP7.2
SDO1: IC1.53 (SDO1/RF8), JP7.1
VDD: C5.1, C6.1, C9.1, C13.1, C16.1, C19.1, C27.1, IC1.2 (VDD), IC1.16 (VDD), IC1.30 (AVDD), IC1.37 (VDD), IC1.46 (VDD), IC1.62 (VDD), IC1.86 (ENVREG), IC2.2 (OUT), J1.2, JP6.2, LMC2.1, R4.2, U$4.P$1 (1), U$4.P$2 (2), U$4.P$16 (15)
VDDUSB: C37.2, LED1.A, LED2.A, LED3.A, U$2.1 (VDD), U$2.2 (VDD), U$7.5

Notes on the sheet:
gauge selector is a Switch that chooses between Fuel Gauge A and Fuel Gauge B (Which sid just found at 4AM). We can choose which one to use by flipping the switch.

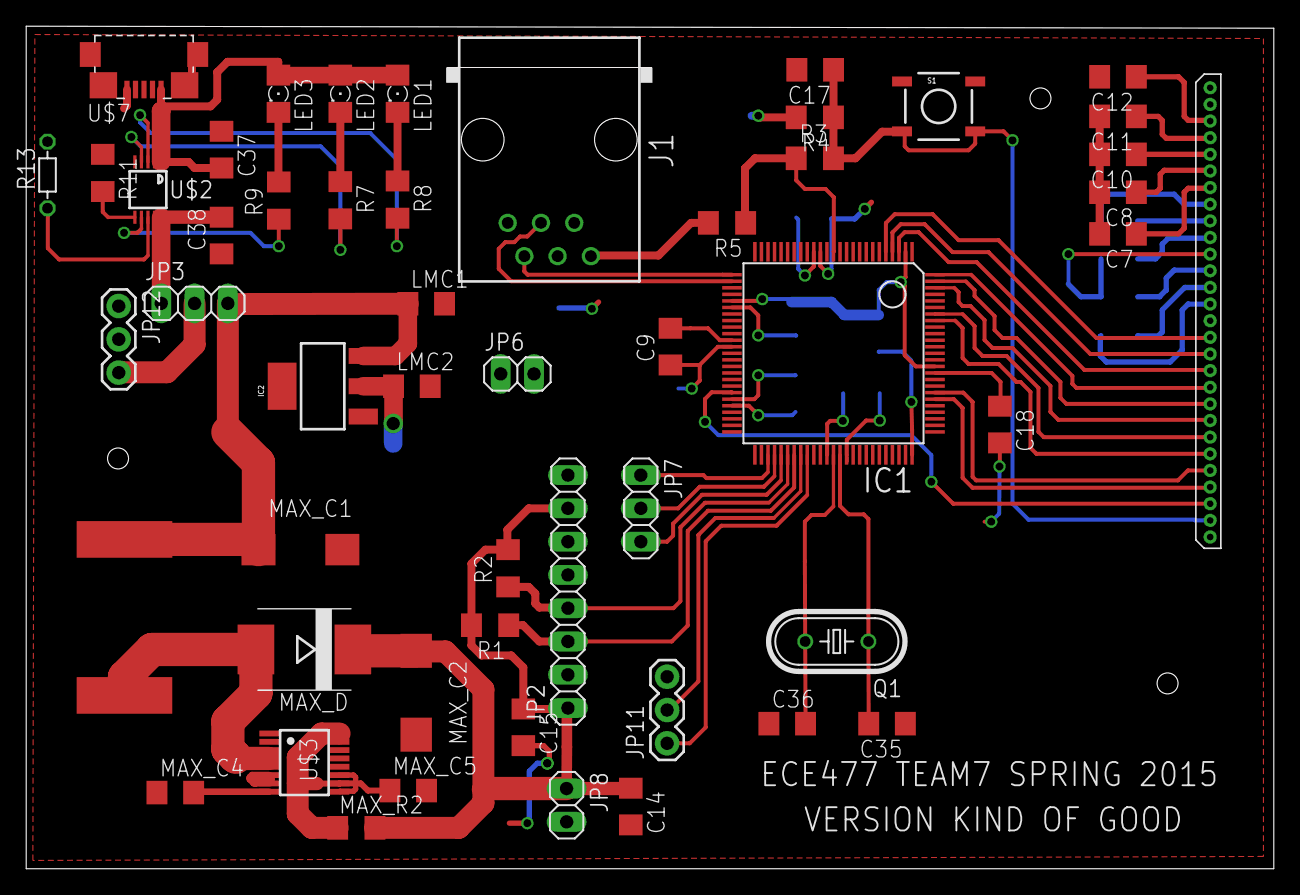
[picture p34: board rev2.brd from above]

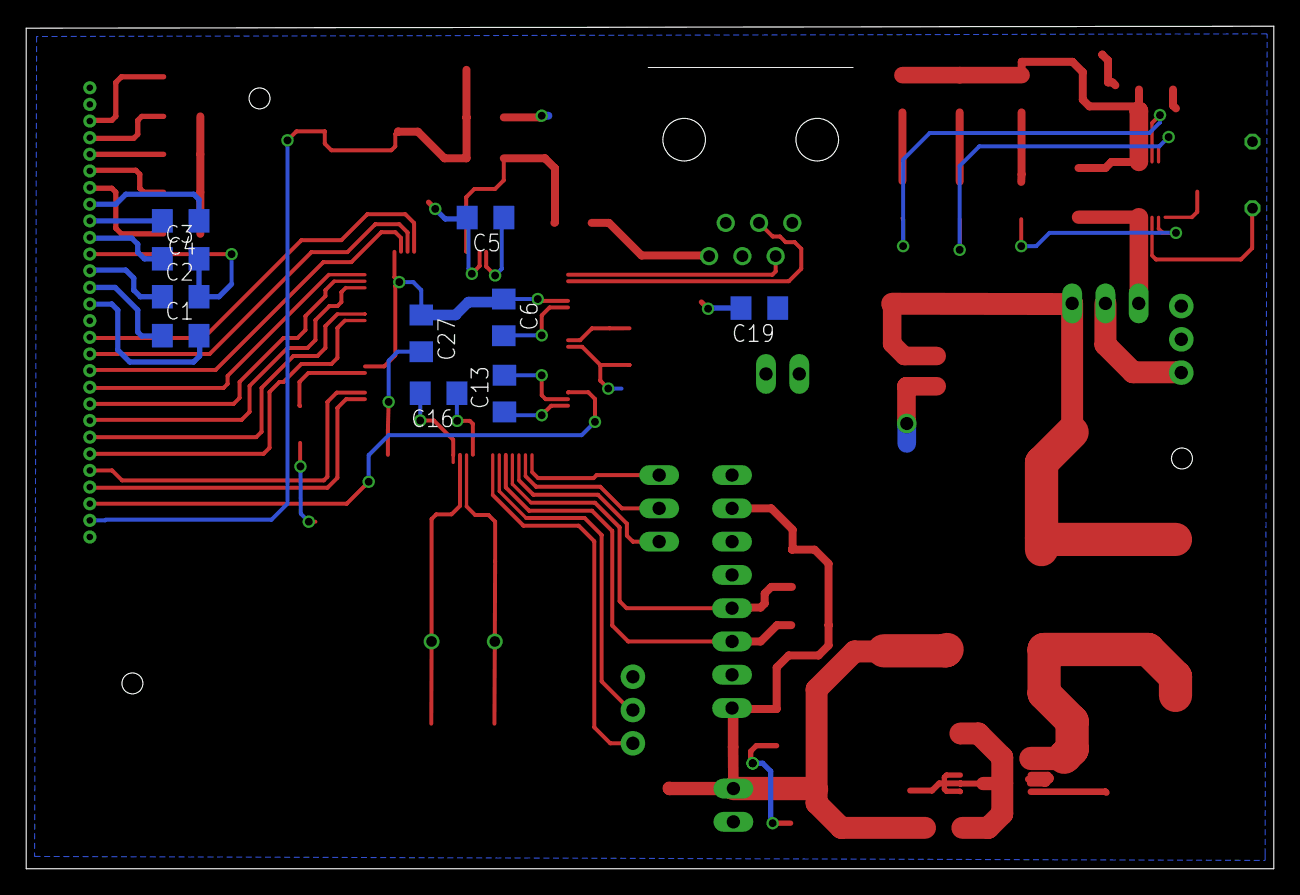
[picture p35: board rev2.brd from below]

Board: 2 copper layers, 95.2 x 64.3 mm, 62 parts (10 on the bottom side), 55 nets.
