redmanduck/wins/raspi/localization/imu.cpp

#include <iostream>
#include <fstream>
#include <thread>

#include "global.h"
#include "imu.h"
#include "kalman.h"
#include "log.h"

namespace wins {

using namespace Eigen;

#define HIGH_VARIANCE 10000
#define ACC_PRECISION 0
#define GYRO_PRECISION 0

namespace {
  double var(vector<double> v) {
    std::vector<double> diff(v.size());
    std::transform(v.begin(), v.end(), diff.begin(),
                   std::bind2nd(std::minus<double>(), mean(v)));
    double sq_sum = std::inner_product(diff.begin(), diff.end(),
        diff.begin(), 0.0);
    double var = (sq_sum / v.size());
    return var;
  }

  void ParseIMU(vector<uint8_t> pic_data, Vector3d& acc,
      Quaternion<double>& quat) {
    acc(0) = ACC_PRECISION * pic_data[0] * 256.0 + pic_data[1];
    acc(1) = ACC_PRECISION * pic_data[2] * 256.0 + pic_data[3];
    acc(2) = ACC_PRECISION * pic_data[4] * 256.0 + pic_data[5];
    quat.w() = GYRO_PRECISION * pic_data[6] * 256.0 + pic_data[7];
    quat.x() = GYRO_PRECISION * pic_data[8] * 256.0 + pic_data[9];
    quat.y() = GYRO_PRECISION * pic_data[10] * 256.0 + pic_data[11];
    quat.z() = GYRO_PRECISION * pic_data[12] * 256.0 + pic_data[13];
    quat.normalize();
  }
}

MatrixXd Imu::X(SVARS, 1);
MatrixXd Imu::P(SVARS, SVARS);
MatrixXd Imu::R(SVARS, SVARS);
MatrixXd Imu::Q(SVARS, SVARS);
MatrixXd Imu::H(SVARS, SVARS);
MatrixXd Imu::H_t(SVARS, SVARS);

vector<double> Imu::current_state;
vector<double> Imu::current_variance;
vector<double> Imu::sensor_variance;
vector<double> Imu::process_variance;

ImuResult Imu::imu_buffer_;
mutex Imu::imu_buffer_mutex_;
atomic_bool Imu::calibrated_(false);
Quaternion<double> Imu::north_quat_inverse_ = Quaternion<double>::Identity();
double Imu::initial_yaw_ = 0;

void Imu::Init() {
  // Observation matrix.
  H.setIdentity();
  //for (int i = 0; i < IMUS; ++i) {
  //  H(i * 2, 4) = 1;
  //  H(i * 2 + 1, 5) = 1;
  //}
  H_t = H.transpose();

  X.setZero();
  P = HIGH_VARIANCE * MatrixXd::Identity(SVARS, SVARS);

  // Velocity is zero at start.
  P(2,2) = 0;
  P(3,3) = 0;

  Q.block<2,2>(0,0) = MatrixXd::Identity(2,2) * Global::IMU_QD;
  R.block<2,2>(0,0) = MatrixXd::Identity(2,2) * Global::IMU_R * Global::IMU_QD;
  Q.block<2,2>(2,2) = MatrixXd::Identity(2,2) * Global::IMU_QV;
  R.block<2,2>(4,4) = MatrixXd::Identity(2,2) * Global::IMU_R * Global::IMU_QV;
  Q.block<2,2>(4,4) = MatrixXd::Identity(2,2) * Global::IMU_QA;
  R.block<2,2>(4,4) = MatrixXd::Identity(2,2) * Global::IMU_R * Global::IMU_QA;
}

void Imu::AddReading(double ax, double ay, double az,
    double qw, double qx, double qy, double qz) {
//  Vector3d raw_acc;
//  Quaternion<double> quat;
//  ParseIMU(pic_data, raw_acc, quat);
//
  // Rotate acceleration vector to the default orientation of the gyro first
  // (YPR all zeroes), and then rotate it north orientation.
  if (Global::DataDump.load() and calibrated_) {
    lock_guard<mutex> lock(Global::DumpMutex);
    ofstream dumpfile(Global::DumpFile, ofstream::app);
    dumpfile << "IMU," << ax << "," << ay << "," << az << ","
             << qw << "," << qx << "," << qy << "," << qz << "\n";
    dumpfile.close();
  }
  // extract yaw.

  Quaterniond q(qw, qx, qy, qz);
  //q = north_quat_inverse_ * q;
  double mag = sqrt(q.w() * q.w() + q.z() * q.z());
  double yaw = 2*acos(q.w() / mag);

  Vector3d raw_acc(ax, ay, az);
  raw_acc  = raw_acc * Global::IMU_ACC_SCALE;
  Matrix3d rotation_matrix = (
      q.inverse() * north_quat_inverse_.inverse()
      ).toRotationMatrix();
  Vector3d acc = rotation_matrix * raw_acc;
  double torotate = (yaw - initial_yaw_);
  torotate = 0;
  //cout << "angle = " << torotate * 180 / M_PI << "\n";
  rotation_matrix =
      AngleAxisd(Global::IMU_Z_Correction - torotate,
          Vector3d::UnitZ()) *
      AngleAxisd(Global::IMU_Y_Correction,// - (yaw - initial_yaw_),
          Vector3d::UnitY()) *
      AngleAxisd(Global::IMU_X_Correction, Vector3d::UnitX());
  Vector3d corrected = rotation_matrix * acc;
  acc = corrected;
  ax = acc(0);
  ay = acc(1);
  az = acc(2);
  //std::cout << "after: " << ax <<", " << ay << ", " << az << "\n";
  lock_guard<mutex> lock(imu_buffer_mutex_);
  //FILE_LOG(logIMU) << "Adding reading ax: " << ax
  //                              << ", ay: " << ay
  //                              << ", az: " << az
  //                              << ", qw: " << qw
  //                              << ", qx: " << qx
  //                              << ", qy: " << qy
  //                              << ", qz: " << qz << "\n";
  imu_buffer_.readings.push_back({ ax, ay, az, qw, qx, qy, qz, yaw });
  //FILE_LOG(logIMU) << "Buffer size: " << imu_buffer_.readings.size() << "\n";
}

void Imu::Calibrate() {
  calibrated_ = false;
  north_quat_inverse_.setIdentity();
  initial_yaw_ = 0;
  {
    lock_guard<mutex> lock(imu_buffer_mutex_);
    imu_buffer_.readings.clear();
  }

  // Collect imu readings for 1 sec.
  if (not Global::NoSleep) {
    this_thread::sleep_for(chrono::seconds(1));
  }

  // Average IMU readings.
  Vector3d avals = Vector3d::Zero();
  VectorXd vals = VectorXd::Zero(4);
  lock_guard<mutex> lock(imu_buffer_mutex_);
  for (auto r : imu_buffer_.readings) {
    avals(0) += r[0];
    avals(1) += r[1];
    avals(2) += r[2];
    vals(0) += r[3];
    vals(1) += r[4];
    vals(2) += r[5];
    vals(3) += r[6];
  }
  if (imu_buffer_.readings.size() != 0) {
    avals /= imu_buffer_.readings.size();
    double angle = acos(avals.normalized().dot(-Vector3d::UnitZ()));
    Vector3d axis = avals.cross(-Vector3d::UnitZ()).normalized();

    vals /= imu_buffer_.readings.size();
    // Set the average value as the quat representing north orentation.
    north_quat_inverse_ = Quaternion<double>(vals(0), vals(1), vals(2), vals(3))
        .inverse();
    //north_quat_inverse_ = AngleAxisd(angle, axis);

    // extract yaw.
    //double mag = sqrt(q.w() * q.w() + q.z() * q.z());
    double mag = sqrt(vals(0) * vals(0) + vals(3) * vals(3));
    initial_yaw_ = 2*acos(vals(0) / mag);
    //initial_yaw_ = vals(4);
  } else {
    north_quat_inverse_.setIdentity();
  }

  // Clear IMU buffer and mark as calibrated.
  imu_buffer_.readings.clear();
  calibrated_ = true;
}

Quaternion<double> Imu::GetNorthQuat() {
  return north_quat_inverse_.inverse();
}

void Imu::SetNorthQuat(double w, double x, double y, double z) {
  north_quat_inverse_ = Quaterniond(w, x, y, z).inverse();
}

vector<double> Imu::RelativeToNorth(double w, double x, double y, double z) {
  Quaternion<double> q(w, x, y, z);
  Quaternion<double> qn = north_quat_inverse_ * q;
  return { qn.w(), qn.x(), qn.y(), qn.z() };
}

PointEstimate Imu::DoKalman(const ImuResult& imu_result, double duration,
    ImuVariant v) {
  vector<double> vals_x;
  vector<double> vals_y;
  vector<double> vals_z;
  for (auto r : imu_result.readings) {
    vals_x.push_back(r[0]);
    vals_y.push_back(r[1]);
    vals_z.push_back(r[2]);
    //FILE_LOG(logIMU) << "(" << r[0] << ", " << r[1] << ")|";
  }
  auto mean_x = mean(vals_x);
  auto mean_y = mean(vals_y);
  auto mean_z = mean(vals_z);
  auto var_x = var(vals_x);
  auto var_y = var(vals_y);

  auto delta_t = Global::IMU_DELTA_T;

  Matrix<double, SVARS, 1> x_sum = X;
  Matrix<double, SVARS, SVARS> p_sum = P;
  Matrix<double, SVARS, 1> z_sum;
  z_sum.setZero();

  auto X_initial = X;

  // State transition matrix.
  Matrix<double, SVARS, SVARS> A;
  A << 1, 0, delta_t, 0, delta_t * delta_t / 2, 0,
       0, 1, 0, delta_t, 0, delta_t * delta_t / 2,
       0, 0, 1, 0, delta_t, 0,
       0, 0, 0, 1, 0, delta_t,
       0, 0, 0, 0, 1, 0,
       0, 0, 0, 0, 0, 1;
  Matrix<double, SVARS, SVARS> A_t = A.transpose();

  Eigen::IOFormat CleanFmt(4, 0, ", ", "\n", "[", "]");
  FILE_LOG(logIMU) << "-------------------------------";
  FILE_LOG(logIMU) << "var_x: " << var_x << "\n";
  FILE_LOG(logIMU) << "var_y: " << var_y << "\n";
  //std::cout << "delta_t: " << delta_t << "\n";
  //std::cout << "R :\n" << R.format(CleanFmt) << "\n";
  //std::cout << "Q :\n" << Q.format(CleanFmt) << "\n";
  //std::cout << "X before:\n" << X.format(CleanFmt) << "\n";
  //FILE_LOG(logIMU) << "P before:\n" << P.format(CleanFmt) << "\n";
  //  z_sum += Z;

  for (auto& reading : imu_result.readings) {
    Matrix<double, SVARS, 1> Z;
    Z.block<4,1>(0,0) = X.block<4,1>(0,0);

    //// Copy X and Y acc values to measurement vector Z.
    //for (int i = 0; i < SVARS; ++i) {
    //  Z(i, 0) = reading[i];
    //}
    Z(4,0) = reading[0];
    Z(5,0) = reading[1];
    Z = A * Z;

    X = (1 - Global::IMU_R) * X + Global::IMU_R * Z;
    //printf("A: %f, %f, %f\n", reading[0], reading[1], reading[2]);
    //printf("Z: %f, %f, %f, %f, %f, %f\n", Z(0,0), Z(1,0), Z(2,0), Z(3,0), Z(4,0), Z(5,0));
    //KalmanUpdate(X, P, Z, A, A_t, H, H_t, R, Q);
    x_sum = X;
    //p_sum = P;

  //  KalmanUpdate(X, P, Z, A, A_t, H, H_t, R, Q);
  //  //FILE_LOG(logIMU) << "P intermediate:\n" << P.format(CleanFmt) << "\n";
  //  x_sum += X;
  //  p_sum += P;
  //  z_sum += Z;
  }
  //printf("X: %f, %f, %f, %f, %f, %f\n", X(0,0), X(1,0), X(2,0), X(3,0), X(4,0), X(5,0));

  if (imu_result.readings.size() == 0) {
    std::cout << "NO IMU READINGS!!\n";
  }
  auto average_state = x_sum.array() *
      1.0 / (imu_result.readings.size());
  //auto average_error = p_sum.array() *
  //    1.0 / (imu_result.readings.size());
  //printf("A: %f, %f, %f\n", mean_x, mean_y, mean_z);
  //auto average_z = z_sum.array() *
  //    1.0 / (imu_result.readings.size() + 1);
  //std::cout << "Average X:\n" << average_state.format(CleanFmt) << "\n";
  //std::cout << "Average Z:\n" << average_z.format(CleanFmt) << "\n";
  //std::cout << "P after:\n" << P.format(CleanFmt) << "\n";

  if (v == IMU_VARIANT_KALMAN_DISTANCE_AVG) {
    X.block<2,1>(0,0) = average_state.block<2,1>(0,0);
    //P.block<2,2>(0,0) = average_error.block<2,2>(0,0);
  } else if (v == IMU_VARIANT_KALMAN_ALL_AVERAGE) {
    X = average_state;
    //P = average_error;
  } else if (v == IMU_VARIANT_KALMAN_VELOCITY_AVG) {
    X.block<2,1>(0,0) = X_initial.block<2,1>(0,0).array() +
        average_state.block<2,1>(2,0).array() * duration;
    X.block<2,1>(2,0) = average_state.block<2,1>(2,0);
    //P.block<4,4>(0,0) = average_error.block<4,4>(0,0);
  }
  //std::cout << "X after:\n" << X.format(CleanFmt) << "\n";
  FILE_LOG(logIMU) << "P fixed:\n" << P.format(CleanFmt) << "\n";

  return { X(0,0), P(0,0), X(1,0), P(1,1) };
}

PointEstimate Imu::EstimateLocation(double duration, ImuVariant v) {
  // If not calibrated don't use IMU.
  if (not calibrated_) {
    return { X(0,0), P(0,0), X(1,0), P(1,1) };
  }

  ImuResult results;

  // Create deep copy of imu_buffer_.
  {
    lock_guard<mutex> lock(imu_buffer_mutex_);
    results = imu_buffer_;
    FILE_LOG(logIMU) << "Buffer size: " << results.readings.size();
    imu_buffer_.readings.clear();
    FILE_LOG(logIMU) << "Clearing buffer on estimation\n";
  }
  return DoKalman(results, duration, v);
}
/*
PointEstimate Imu::EstimateLocation1(PointEstimate current) {
  auto imu_result = FetchAll();
  vector<double> sum(0, IMUS * 4);
  for (auto& reading : imu_result.readings) {
    // Predict how much error.
    auto variance_prediction = current_variance + process_variance;

    // Compare readings against prediction.
    auto innovation = reading - current_state;

    // Compare real error against prediction.
    auto innovation_variance = variance_prediction + sensor_variance;

    // Moderate the prediction.
    auto kalman_gain = variance_prediction / innovation_variance;

    current_state = current_state + kalman_gain * innovation;
    current_variance = (vector<double>(0, STATE_SIZE) - kalman_gain) *
                        variance_prediction;
  }
  auto average_state = sum / vector<double>(imu_result.readings.size(),
      STATE_SIZE);
} */

}
