redmanduck/wins/pic/project.X/lcd.c

#include "lcd.h"
#include "p24fxxxx.h"

void SPI2Init(void)
{
    //config SPI2
    SPI2STATbits.SPIEN 		= 0;	// disable SPI port
    SPI2STATbits.SPISIDL 	= 0; 	// Continue module operation in Idle mode

    SPI2BUF 				= 0;   	// clear SPI buffer

    IFS2bits.SPI2IF 		= 0;	// clear interrupt flag
    IEC2bits.SPI2IE 		= 0;	// disable interrupt

    SPI2CON1bits.DISSCK		= 0;	// Internal SPIx clock is enabled
    SPI2CON1bits.DISSDO		= 0;	// SDOx pin is controlled by the module
    SPI2CON1bits.MODE16 	= 0;	// set in 16-bit mode, clear in 8-bit mode
    SPI2CON1bits.SMP		= 0;	// Input data sampled at middle of data output time
    SPI2CON1bits.CKP 		= 0;	// CKP and CKE is subject to change ...
    SPI2CON1bits.CKE 		= 1;	// ... based on your communication mode.
    SPI2CON1bits.MSTEN 		= 1; 	// 1 =  Master mode; 0 =  Slave mode
    SPI2CON1bits.SPRE 		= 7; 	// Secondary Prescaler = 4:1
    SPI2CON1bits.PPRE 		= 3; 	// Primary Prescaler = 1:1

    SPI2CON2 				= 0;	// non-framed mode

    SPI_SS_PORT				= 1;	//
    SPI_SS_TRIS				= 0;	// set SS as output

    SPI2STATbits.SPIEN 		= 1; 	// enable SPI port, clear status
}

unsigned short writeSPI2( unsigned short data )
{
    SPI2BUF = data;					// write to buffer for TX
    while(!SPI2STATbits.SPIRBF);	// wait for transfer to complete
    return SPI2BUF;    				// read the received value
}//writeSPI2

void LCDinit(void){
        LCD_comm(CMD_SET_BIAS_9);
        LCD_comm(CMD_SET_ADC_NORMAL);
        LCD_comm(CMD_SET_COM_NORMAL);
        LCD_comm(CMD_SET_DISP_START_LINE);
        LCD_comm(CMD_SET_POWER_CONTROL | 0x4);
        LCD_comm(CMD_SET_POWER_CONTROL | 0x6);
        LCD_comm(CMD_SET_POWER_CONTROL | 0x7);
        LCD_comm(CMD_SET_RESISTOR_RATIO | 0x6);
        LCD_comm(0x25);
        LCD_comm(0x81);
        LCD_comm(0x19);
        LCD_comm(0x2F);
        LCD_comm(0xAF);
        LCD_comm(0xA4);
}

void LCD_comm(unsigned char c){
    PORTAbits.RA0 = 0;
    writeSPI2(c);
}

void LCD_data(unsigned char c){
    PORTAbits.RA0 = 1;
    writeSPI2(c);
}
