redmanduck/wins/raspi/localization/world.h

#ifndef WXORLD_H
#define WXORLD_H
//#define WORLD_WMAX 170
//#define WORLD_HMAX 128
//#define ORIGIN_X 15
//#define ORIGIN_Y 39 
//WORLD is workspace
//WORLD_MAP is world map

int WORLD_SIZE; //in BYTE

int ORIGIN_X = 15;
int ORIGIN_Y = 37;
int WORLD_WMAX = 170;
int WORLD_HMAX = 128;

uint8_t * WORLD;
uint8_t * WORLD_MAP;

#endif
