redmanduck/wins/raspi/localization/location.h

#ifndef LOCATION_H
#define LOCATION_H

#include<Eigen/Dense>

#include "common_utils.h"
#include "fake_wifiscan.h"
#include "kdtree/node.hpp"
#include "point.h"
#include "wifi_estimate.h"
#include "wifiscan.h"

namespace wins {

enum LocationVariant {
  LOCATION_VARIANT_NONE       = 0,
  LOCATION_VARIANT_FIXED_R    = 1,
  LOCATION_VARIANT_UPDATE_IMU = 2
};

class Location {
 private:
  static LocationVariant variant_;
  static int unknown_count_;
  static double max_distance_;

  static chrono::steady_clock::time_point tp_epoch_;
  static chrono::steady_clock::time_point last_update_time_;

  static Eigen::MatrixXd prev_X;
  static Eigen::MatrixXd prev_P;
  static Eigen::MatrixXd A;
  static Eigen::MatrixXd A_t;
  static Eigen::MatrixXd const_R;

  static vector<unique_ptr<WiFiEstimate>> wifi_estimators_;
  static atomic<kdtree::node<Point*>*> current_node_;
  static PointEstimate point_estimate_;

  static void InitialEstimate();
  static void InitKalman();
  static bool DoKalmanUpdate(vector<PointEstimate> wifi_estimates);

 public:
  static double imu_x;
  static double imu_y;
  static double wifi_x;
  static double wifi_y;
  static double kalman_x;
  static double kalman_y;
  static double prev_x;
  static double prev_y;

  static vector<PointEstimate> GetWiFiReadings(int count = 1);
  static void Init();
  static kdtree::node<Point*>* GetCurrentNode();
  static void UpdateEstimate();

  static vector<FakeWifiScan*> TestInit(vector<vector<Result>> setup_points,
      int num_wifis);
  static vector<Result> GetScans();
  static void TestSetCurrentNode(kdtree::node<Point*>* node);
};

}

#endif
