redmanduck/wins/raspi/localization/wifi_estimate.h

#ifndef WIFI_ESTIMATE_H
#define WIFI_ESTIMATE_H

#include "common_utils.h"
#include "scan_result.h"
#include "wifiscan.h"

namespace wins {

class WiFiEstimate {
 public:
  unique_ptr<WifiScan> scanner_;

  vector<PointEstimate> ClosestByMahalanobis(
      vector<Result> s, WiFiVariant v,
      double realx = -1, double realy = -1,
      double exp1 = 10, double exp2 = 0, bool debug = false);
      //double exp1 = 5, double exp2 = 3, bool debug = false);
  // PointEstimate ClosestByMahalanobisVarWeighted(vector<Result> s);
  // PointEstimate MahalanobisTriangulated(vector<Result> s);
  vector<PointEstimate> MostProbableClubbed(vector<Result> s,
      double realx = -1, double realy = -1,
      double exp1 = 2.0, double exp2 = 0.0, bool debug = false);
  vector<PointEstimate> MostProbableNotClubbed(vector<Result> s,
      double realx = -1, double realy = -1,
      double exp1 = 1, double exp2 = 1, bool debug = false);
  WiFiEstimate(unique_ptr<WifiScan> scanner);
  WiFiEstimate() {}
  vector<PointEstimate> EstimateLocation(WiFiVariant v, int read_count = 1);
  vector<Result> GetScans();
};

}

#endif //WIFI_ESTIMATE_H
