redmanduck/wins/raspi/localization/kalman.cpp

#include<Eigen/Dense>

#include "kalman.h"

namespace wins {

using namespace Eigen;

void KalmanUpdate(
    MatrixXd& X,
    MatrixXd& P,
    const MatrixXd& Z,
    const MatrixXd& A,
    const MatrixXd& A_t,
    const MatrixXd& H,
    const MatrixXd& H_t,
    const MatrixXd& R,
    const MatrixXd& Q) {
  // State prediction.
  MatrixXd X_pred = A * X;

  // Covariance prediction.
  MatrixXd P_pred = A * P * A_t + Q;

  // Innovation.
  MatrixXd Y = Z - H * X_pred;

  // Innovaion covariance.
  MatrixXd I = H * P_pred * H_t + R;

  // Kalman gain.
  MatrixXd K = P_pred * H_t * I.inverse();

  // State update.
  X += K * Y;

  // Covariance update.
  P = (MatrixXd::Identity(P.rows(), P.cols()) - K * H) * P_pred;
}

}
