redmanduck/wins/raspi/localization/navigation.h

#ifndef NAVIGATION_H
#define NAVIGATION_H

#include <mutex>

#include "common_utils.h"
#include "kdtree/node.hpp"
#include "point.h"

namespace wins {

class Navigation {
 private:
  static kdtree::node<Point*>* destination_node_;
  static vector<kdtree::node<Point*>*>::reverse_iterator current_start_;
  static vector<kdtree::node<Point*>*> current_route_;
  static unordered_set<kdtree::node<Point*>*> nearby_route_;
  static bool navigating_;

 public:
  static mutex route_mutex;
  static bool TrySetDestinationFromCoords(string s);
  static void UpdateRoute();
  static void ResetDestination();
  static kdtree::node<Point*>* const GetDestination();
  static vector<kdtree::node<Point*>*>::const_reverse_iterator route_begin();
  static vector<kdtree::node<Point*>*>::const_reverse_iterator route_end();
  static vector<kdtree::node<Point*>*>::const_reverse_iterator current_begin();
};

}

#endif
