redmanduck/wins/raspi/test/winsdrawAPI/winsdrawAPI/canvas.h

//
//  canvas.h
//  winsdrawAPI
//
//  Created by Pat Sabpisal on 3/27/15.
//  Copyright (c) 2015 Pat Sabpisal. All rights reserved.
//

#ifndef __winsdrawAPI__canvas__
#define __winsdrawAPI__canvas__

#include <stdio.h>
#include <string>
#include "IPoint.h"
#include "bitmap_image.hpp"

#ifndef CANVAS_H
#define	CANVAS_H

enum InkStyle {
    INK_STYLE_THICK,
    INK_STYLE_NORMAL,
    INK_STYLE_DOUBLE
};



class Kyanvas {
public:
    Kyanvas(int w, int h);
    uint8_t * getRowData(int i);
    uint8_t ** getBitmap();
    void clear();
    int countRows();
    int countColumns();
    void printCanvas();
    void drawLine(InkStyle istyle, IPoint * start, IPoint * end);
    void drawText(std::string text, IPoint * origin, int fontscale);
    int percentWidthToPixel(int percent);
    int percentHeightToPixel(int percent);
    void drawRectangle(InkStyle istyle, int width_px, int height_px, IPoint * origin);
    void drawCircle(InkStyle istyle, int radius, IPoint * centre);
    void toBitmap(std::string filename);
private:
    int width;
    int height;
    void putPixel(int x, int y);
    void clearPixel(int x, int y);
    uint8_t ** bitmap;
};

#endif	/* CANVAS_H */

#endif /* defined(__winsdrawAPI__canvas__) */
