redmanduck/wins/raspi/test/winsdrawAPI/winsdrawAPI/IPoint.cpp

//
//  IPoint.cpp
//  winsdrawAPI
//
//  Created by Pat Sabpisal on 3/28/15.
//  Copyright (c) 2015 Pat Sabpisal. All rights reserved.
//

#include "IPoint.h"

IPoint::IPoint(int a, int b){
    this->x = a;
    this->y = b;
}
