redmanduck/wins/raspi/test/winsdrawAPI/winsdrawAPI/IPoint.h

//
//  IPoint.h
//  winsdrawAPI
//
//  Created by Pat Sabpisal on 3/28/15.
//  Copyright (c) 2015 Pat Sabpisal. All rights reserved.
//

#ifndef __winsdrawAPI__IPoint__
#define __winsdrawAPI__IPoint__

#include <stdio.h>

class IPoint{
public:
    int x;
    int y;
    IPoint(int a, int b);
};

#endif /* defined(__winsdrawAPI__IPoint__) */
