redmanduck/wins/(commit log)

2015-01-25 Analysis script corrected, new data analyzed
    [10ec3477_01_22-23.csv, 10ec3477_01_22-23_2.csv, 10ec3477_01_22-23_analysis.xlsx, ec1477_01_22-23.csv, ec1477_01_22-23.xlsx, ec3477_01_22-23.csv, ec3477_01_22-23_2.csv]
2015-02-04 SPI testing
2015-02-10 Localization algorithms added
    [10ec3477_01_22-23.csv, 10ec3477_01_22-23_2.csv, ec1477_01_22-23.xlsx]
2015-02-15 Sample.json added, kd tree integrated
2015-02-20 Preliminary Mahalanobis localization working
    [results.csv]
2015-02-21 + Mahalobis distance estimation : added chi squared prob variant + Unique_ptr based memory system implemented
    [results.csv]
2015-02-26 Implemented Kalman Filter and IMU data analysis
2015-03-11 Version in design review
    [pcb_schematic.brd, pcb_schematic.sch]
2015-03-13 version one done
    [rev2.brd]
2015-03-13 go duck
    [rev2.brd, rev2.sch]
2015-03-14 VERSION 1 with everything
    [rev2.brd, rev2.sch]
2015-03-14 VERSION UNRELIABLE
    [rev2.brd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]
2015-03-24 Wifi localization default algorithm changed
    [results.csv]
2015-03-25 Incomplete changes: main, localization, spi, display, navigation
2015-03-28 レーゴウ
2015-03-29 WiFi fine tuning
    [analysis10_results.csv, analysis11_results.csv, analysis6_results.csv, analysis7_results.csv, analysis8_results.csv, analysis9_results.csv, analysis_summary.csv, results.csv]
2015-03-30 Errors in test fixed
    [generate_learns.py, test_helpers.cpp, wifi_estimate.cpp]
2015-03-31 Fine tune script correctins
    [find_best_exps.py, generate_learns_single.py, generate_learns_split.py, test.cpp, test_helpers.cpp, wifi_estimate.cpp]
2015-03-31 I see stagedDaulet
2015-03-31 More WiFi script fixes
    [test_helpers.cpp, wifi_estimate.cpp]
2015-04-03 Location combine code added Missing header global.h added
    [global.h, kalman.h, location.cpp, location.h]
2015-04-08 updated pic folder, no changes in pcb_REV2 should be done
2015-04-08 updated pic with fixed spi communication between pic and pi
    [rev2.brd]
2015-04-08 Updated PIC. working SPI interface. battery levels on I2C2. IMU on I2C1
2015-04-10 Added test file for display.cpp
    [dump.txt]
2015-04-10 Replaced prints with logging
    [global.h, keypad_handler.cpp, location.cpp]
2015-04-12 Chi sqaured WiFi algorithm fix
    [wifi_estimate.cpp]
2015-04-12 map data bug fix
    [test_helpers.cpp, to_cpp.py, wifi_estimate.cpp]
2015-04-12 Forward and reverse runs combined
    [combine.py]
2015-04-13 Top level kalman filter Q and R added, clean up
2015-04-14 WiFi with Kalman filter testing
2015-04-14 Top level Kalman filter done(?)
2015-04-15 Peter ye
    [dump.txt]
2015-04-15 "Missing bracket added"
2015-04-15 Prints added
2015-04-15 some update, imu does not work
    [lcdPmp.c, lcdPmp.h, main.c]
2015-04-15 Kenzhebalin SPI protocol implemented
2015-04-16 WINS Map Assembly Instruction for Path AB
2015-04-17 IMU Calibrating added
2015-04-19 Pat's caching filter integrated
2015-04-19 Dont quit if scan failed
    [wifiscan.cpp]
2015-04-19 Bug fixes in wifiscan
    [wifiscan.cpp]
2015-04-19 New monitor.cpp with I2c DMP
2015-04-24 SPI integrated
2015-04-24 Calibration added
2015-04-24 Log filtering added
2015-04-29 gdb printers added
2015-04-30 Map shift and prevent weird
    [display.cpp, world.h]
2015-04-30 very inefficient but politcally correct
    [display.cpp, display.h, world.h]
2015-04-30 Fixed byte order bug drawing
    [display.cpp, display.h]
2015-04-30 Imu tuning code added
2015-05-01 imu, wifi analysis code added
2015-05-01 Maybe this will fix ARM?
    [display.cpp]
2015-05-03 data and bug fixes
    [display.cpp, display.h, global.cpp, global.h, imu.cpp, location.cpp, test.cpp, wifi_estimate.cpp]
2015-05-04 Calibration fix
2015-05-06 imu protection
2015-05-06 Should fix the shifting out of screen
    [display.cpp]
2015-05-06 imu optimization TEST
